alanhpereira/fluxdrive-g4/hardware/fluxdrive-g4.kicad_pcb

## KiCad design hardware/fluxdrive-g4.kicad_pcb (2026-10-22)

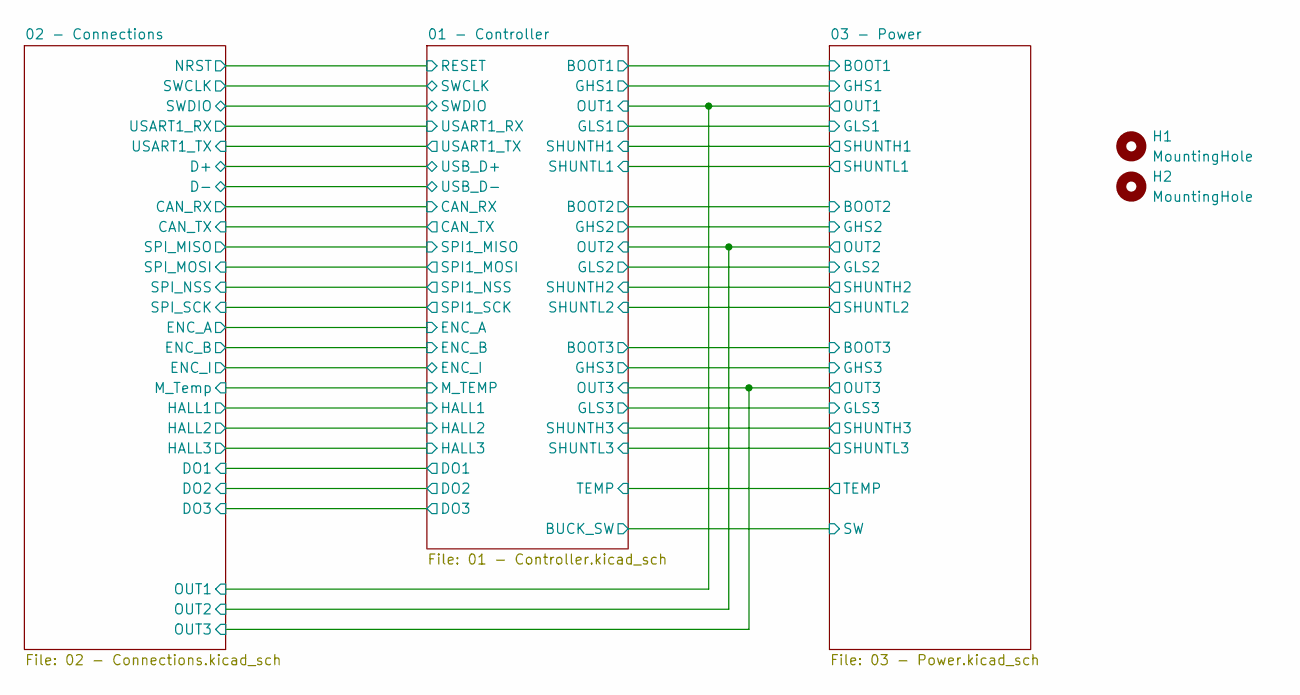
[picture p2: schematic fluxdrive-g4.kicad_sch]

Parts:
H1, H2: MountingHole; MountingHole_2.2mm_M2

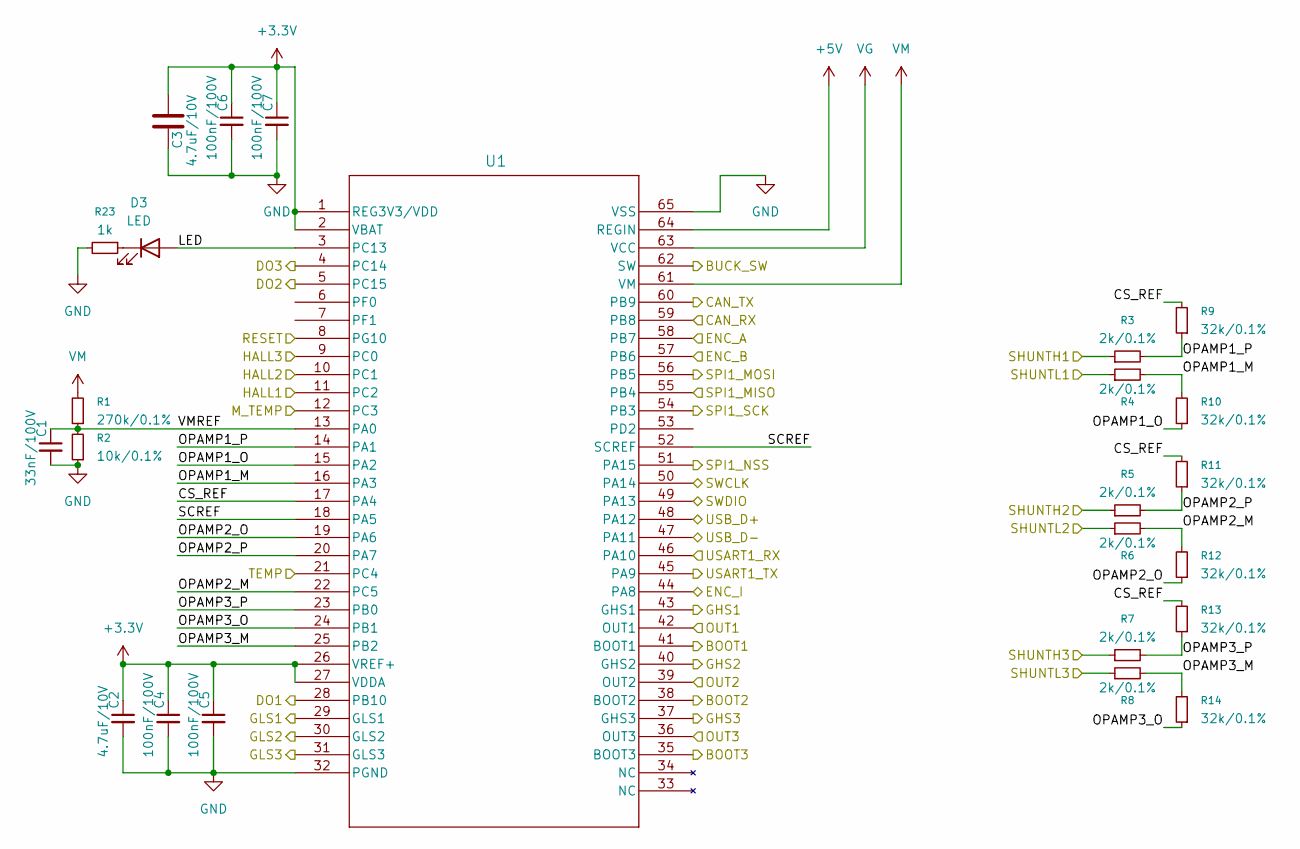
[picture p3: schematic 01 - Controller.kicad_sch]

Parts:
C1: 33nF/100V; C_0603_1608Metric
C2, C3: 4.7uF/10V; C_0603_1608Metric
C4, C5, C6, C7: 100nF/100V; C_0603_1608Metric
D3: LED; LED_0603_1608Metric
R1: 270k/0.1%; R_0603_1608Metric
R2: 10k/0.1%; R_0603_1608Metric
R3, R4, R5, R6, R7, R8: 2k/0.1%; R_0603_1608Metric
R9, R10, R11, R12, R13, R14: 32k/0.1%; R_0603_1608Metric
R23: 1k; R_0603_1608Metric
U1: STSPIN32G4TR; QFN_IN32G4_STM-L

Connections:
+3.3V: C2.1, C3.2, C4.1, C5.1, C6.1, C7.1, U1.1 (REG3V3/VDD), U1.2 (VBAT), U1.26 (VREF+), U1.27 (VDDA); also elsewhere on the board
+5V: U1.64 (REGIN); also elsewhere on the board
/01 - Controller/BOOT1: U1.41 (BOOT1); also elsewhere on the board
/01 - Controller/BOOT2: U1.38 (BOOT2); also elsewhere on the board
/01 - Controller/BOOT3: U1.35 (BOOT3); also elsewhere on the board
/01 - Controller/BUCK_SW: U1.62 (SW); also elsewhere on the board
/01 - Controller/CAN_RX: U1.59 (PB8); also elsewhere on the board
/01 - Controller/CAN_TX: U1.60 (PB9); also elsewhere on the board
/01 - Controller/CS_REF: R9.2, R11.2, R13.2, U1.17 (PA4)
/01 - Controller/DO1: U1.28 (PB10); also elsewhere on the board
/01 - Controller/DO2: U1.5 (PC15); also elsewhere on the board
/01 - Controller/DO3: U1.4 (PC14); also elsewhere on the board
/01 - Controller/ENC_A: U1.58 (PB7); also elsewhere on the board
/01 - Controller/ENC_B: U1.57 (PB6); also elsewhere on the board
/01 - Controller/ENC_I: U1.44 (PA8); also elsewhere on the board
/01 - Controller/GHS1: U1.43 (GHS1); also elsewhere on the board
/01 - Controller/GHS2: U1.40 (GHS2); also elsewhere on the board
/01 - Controller/GHS3: U1.37 (GHS3); also elsewhere on the board
/01 - Controller/GLS1: U1.29 (GLS1); also elsewhere on the board
/01 - Controller/GLS2: U1.30 (GLS2); also elsewhere on the board
/01 - Controller/GLS3: U1.31 (GLS3); also elsewhere on the board
/01 - Controller/HALL1: U1.11 (PC2); also elsewhere on the board
/01 - Controller/HALL2: U1.10 (PC1); also elsewhere on the board
/01 - Controller/HALL3: U1.9 (PC0); also elsewhere on the board
/01 - Controller/LED: D3.2 (A), U1.3 (PC13)
/01 - Controller/M_TEMP: U1.12 (PC3); also elsewhere on the board
/01 - Controller/OPAMP1_M: R4.2, R10.2, U1.16 (PA3)
/01 - Controller/OPAMP1_O: R10.1, U1.15 (PA2)
/01 - Controller/OPAMP1_P: R3.2, R9.1, U1.14 (PA1)
/01 - Controller/OPAMP2_M: R6.2, R12.2, U1.22 (PC5)
/01 - Controller/OPAMP2_O: R12.1, U1.19 (PA6)
/01 - Controller/OPAMP2_P: R5.2, R11.1, U1.20 (PA7)
/01 - Controller/OPAMP3_M: R8.2, R14.2, U1.25 (PB2)
/01 - Controller/OPAMP3_O: R14.1, U1.24 (PB1)
/01 - Controller/OPAMP3_P: R7.2, R13.1, U1.23 (PB0)
/01 - Controller/OUT1: U1.42 (OUT1); also elsewhere on the board
/01 - Controller/OUT2: U1.39 (OUT2); also elsewhere on the board
/01 - Controller/OUT3: U1.36 (OUT3); also elsewhere on the board
/01 - Controller/RESET: U1.8 (PG10); also elsewhere on the board
/01 - Controller/SCREF: U1.18 (PA5), U1.52 (SCREF)
/01 - Controller/SHUNTH1: R3.1; also elsewhere on the board
/01 - Controller/SHUNTH2: R5.1; also elsewhere on the board
/01 - Controller/SHUNTH3: R7.1; also elsewhere on the board
/01 - Controller/SHUNTL1: R4.1; also elsewhere on the board
/01 - Controller/SHUNTL2: R6.1; also elsewhere on the board
/01 - Controller/SHUNTL3: R8.1; also elsewhere on the board
/01 - Controller/SPI1_MISO: U1.55 (PB4); also elsewhere on the board
/01 - Controller/SPI1_MOSI: U1.56 (PB5); also elsewhere on the board
/01 - Controller/SPI1_NSS: U1.51 (PA15); also elsewhere on the board
/01 - Controller/SPI1_SCK: U1.54 (PB3); also elsewhere on the board
/01 - Controller/SWCLK: U1.50 (PA14); also elsewhere on the board
/01 - Controller/SWDIO: U1.49 (PA13); also elsewhere on the board
/01 - Controller/TEMP: U1.21 (PC4); also elsewhere on the board
/01 - Controller/USART1_RX: U1.46 (PA10); also elsewhere on the board
/01 - Controller/USART1_TX: U1.45 (PA9); also elsewhere on the board
/01 - Controller/USB_D+: U1.48 (PA12); also elsewhere on the board
/01 - Controller/USB_D-: U1.47 (PA11); also elsewhere on the board
/01 - Controller/VMREF: C1.1, R1.1, R2.2, U1.13 (PA0)
GND: C1.2, C2.2, C3.1, C4.2, C5.2, C6.2, C7.2, R2.1, R23.2, U1.32 (PGND), U1.65 (VSS); also elsewhere on the board
unnamed: D3.1 (K), R23.1
VG: U1.63 (VCC); also elsewhere on the board
VM: R1.2, U1.61 (VM); also elsewhere on the board

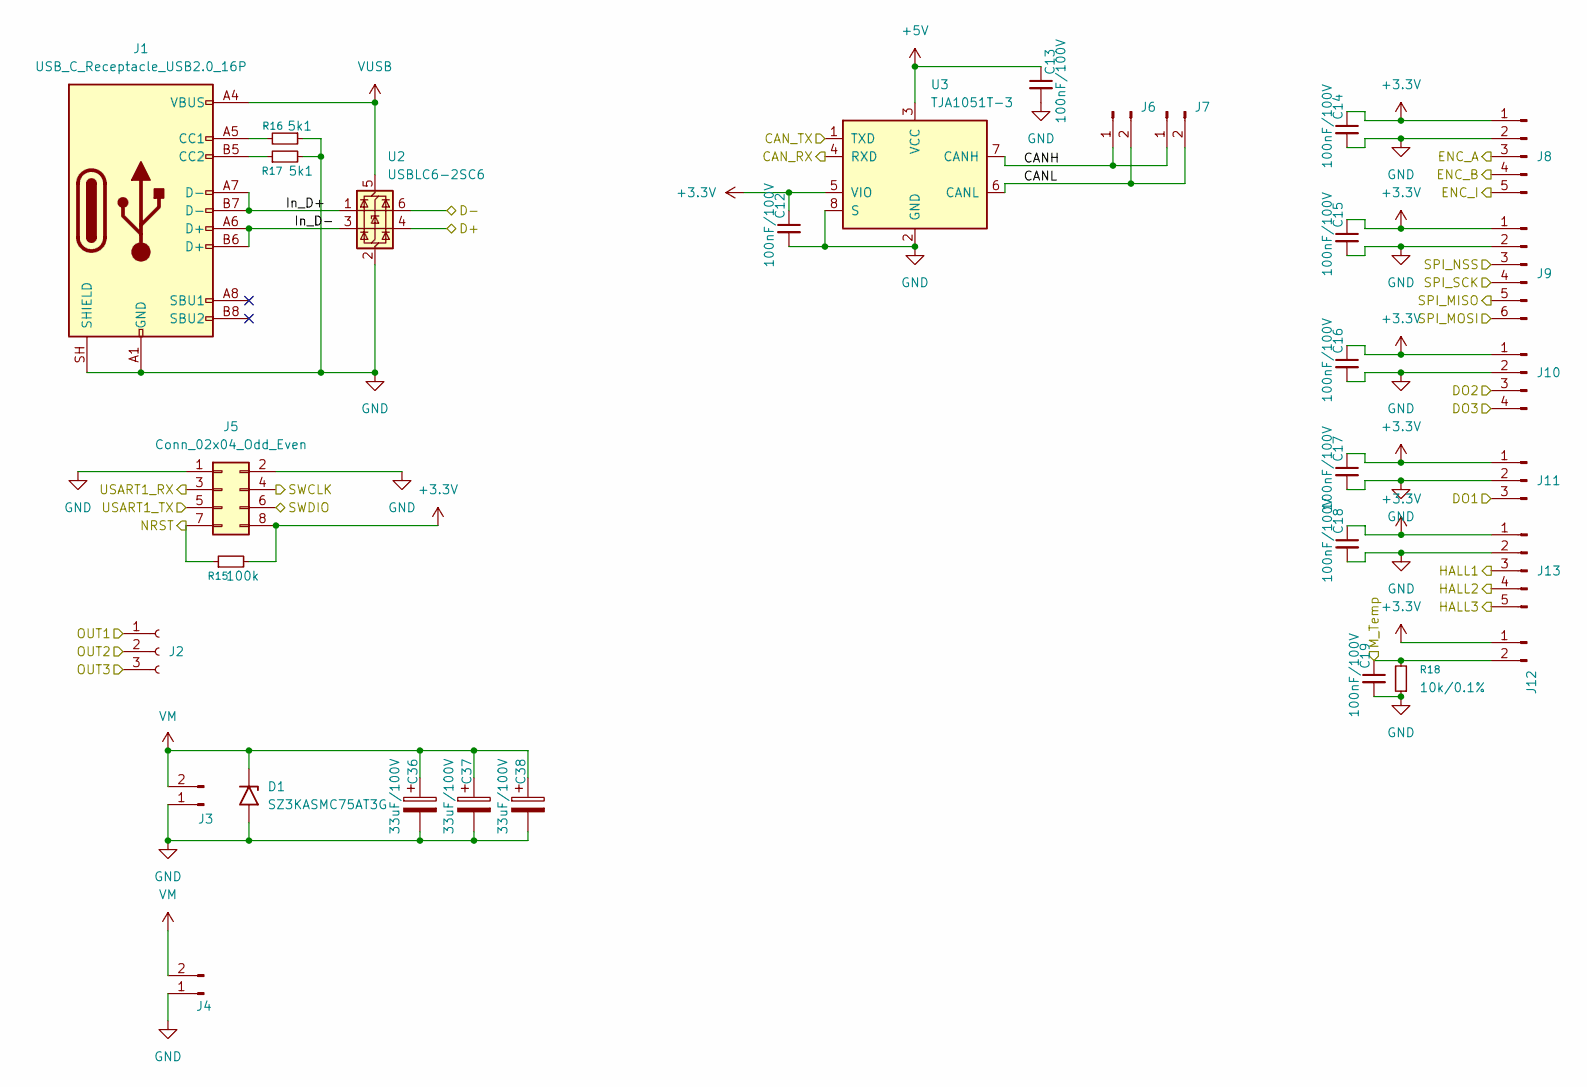
[picture p4: schematic 02 - Connections.kicad_sch]

Parts:
C12, C13, C14, C15, C16, C17, C18, C19: 100nF/100V; C_0603_1608Metric
C36, C37, C38: 33uF/100V; CP_Radial_D8.0mm_P3.50mm
D1: SZ3KASMC75AT3G; D_SMC
J1: USB_C_Receptacle_USB2.0_16P; USB_C_Receptacle_HRO_TYPE-C-31-M-12; LCSC Part C165948
J2: Conn_01x03_Socket; CONN-TH_3P-P3.50_MR30PB-F30.G.Y
J3, J4: Conn_01x02_Pin; AMASS_XT30UPB-M
J5: Conn_02x04_Odd_Even; PinHeader_2x04_P2.54mm_Vertical
J6, J7, J12: Conn_01x02_Pin; JST_PH_B2B-PH-K_1x02_P2.00mm_Vertical
J8, J13: Conn_01x05_Pin; JST_PH_B5B-PH-K_1x05_P2.00mm_Vertical
J9: Conn_01x06_Pin; JST_PH_B6B-PH-K_1x06_P2.00mm_Vertical
J10: Conn_01x04_Pin; JST_PH_B4B-PH-K_1x04_P2.00mm_Vertical
J11: Conn_01x03_Pin; JST_PH_B3B-PH-K_1x03_P2.00mm_Vertical
R15: 100k; R_0603_1608Metric
R16, R17: 5k1; R_0603_1608Metric
R18: 10k/0.1%; R_0603_1608Metric
U2: USBLC6-2SC6; SOT-23-6; LCSC Part C2827654
U3: TJA1051T-3; SOIC-8_3.9x4.9mm_P1.27mm

Connections:
+3.3V: C12.1, C14.1, C15.1, C16.1, C17.1, C18.1, J5.8, J8.1, J9.1, J10.1, J11.1, J12.1, J13.1, R15.2, U3.5 (VIO); also elsewhere on the board
+5V: C13.1, U3.3 (VCC); also elsewhere on the board
/01 - Controller/CAN_RX: U3.4 (RXD); also elsewhere on the board
/01 - Controller/CAN_TX: U3.1 (TXD); also elsewhere on the board
/01 - Controller/DO1: J11.3; also elsewhere on the board
/01 - Controller/DO2: J10.3; also elsewhere on the board
/01 - Controller/DO3: J10.4; also elsewhere on the board
/01 - Controller/ENC_A: J8.3; also elsewhere on the board
/01 - Controller/ENC_B: J8.4; also elsewhere on the board
/01 - Controller/ENC_I: J8.5; also elsewhere on the board
/01 - Controller/HALL1: J13.3; also elsewhere on the board
/01 - Controller/HALL2: J13.4; also elsewhere on the board
/01 - Controller/HALL3: J13.5; also elsewhere on the board
/01 - Controller/M_TEMP: C19.1, J12.2, R18.2; also elsewhere on the board
/01 - Controller/OUT1: J2.1; also elsewhere on the board
/01 - Controller/OUT2: J2.2; also elsewhere on the board
/01 - Controller/OUT3: J2.3; also elsewhere on the board
/01 - Controller/RESET: J5.7, R15.1; also elsewhere on the board
/01 - Controller/SPI1_MISO: J9.5; also elsewhere on the board
/01 - Controller/SPI1_MOSI: J9.6; also elsewhere on the board
/01 - Controller/SPI1_NSS: J9.3; also elsewhere on the board
/01 - Controller/SPI1_SCK: J9.4; also elsewhere on the board
/01 - Controller/SWCLK: J5.4; also elsewhere on the board
/01 - Controller/SWDIO: J5.6; also elsewhere on the board
/01 - Controller/USART1_RX: J5.3; also elsewhere on the board
/01 - Controller/USART1_TX: J5.5; also elsewhere on the board
/01 - Controller/USB_D+: U2.4 (I/O2); also elsewhere on the board
/01 - Controller/USB_D-: U2.6 (I/O1); also elsewhere on the board
/02 - Connections/CANH: J6.1, J7.1, U3.7 (CANH)
/02 - Connections/CANL: J6.2, J7.2, U3.6 (CANL)
/02 - Connections/In_D+: J1.A7 (D-), J1.B7 (D-), U2.1 (I/O1)
/02 - Connections/In_D-: J1.A6 (D+), J1.B6 (D+), U2.3 (I/O2)
GND: C12.2, C13.2, C14.2, C15.2, C16.2, C17.2, C18.2, C19.2, C36.2, C37.2, C38.2, D1.2 (A2), J1.A1 (GND), J1.A12 (GND), J1.B1 (GND), J1.B12 (GND), J1.SH (SHIELD), J3.1, J4.1, J5.1, J5.2, J8.2, J9.2, J10.2, J11.2, J13.2, R16.1, R17.2, R18.1, U2.2 (GND), U3.2 (GND), U3.8 (S); also elsewhere on the board
unnamed: J1.A5 (CC1), R16.2
unnamed: J1.B5 (CC2), R17.1
VM: C36.1, C37.1, C38.1, D1.1 (A1), J3.2, J4.2; also elsewhere on the board
VUSB: J1.A4 (VBUS), J1.A9 (VBUS), J1.B4 (VBUS), J1.B9 (VBUS), U2.5 (VBUS); also elsewhere on the board

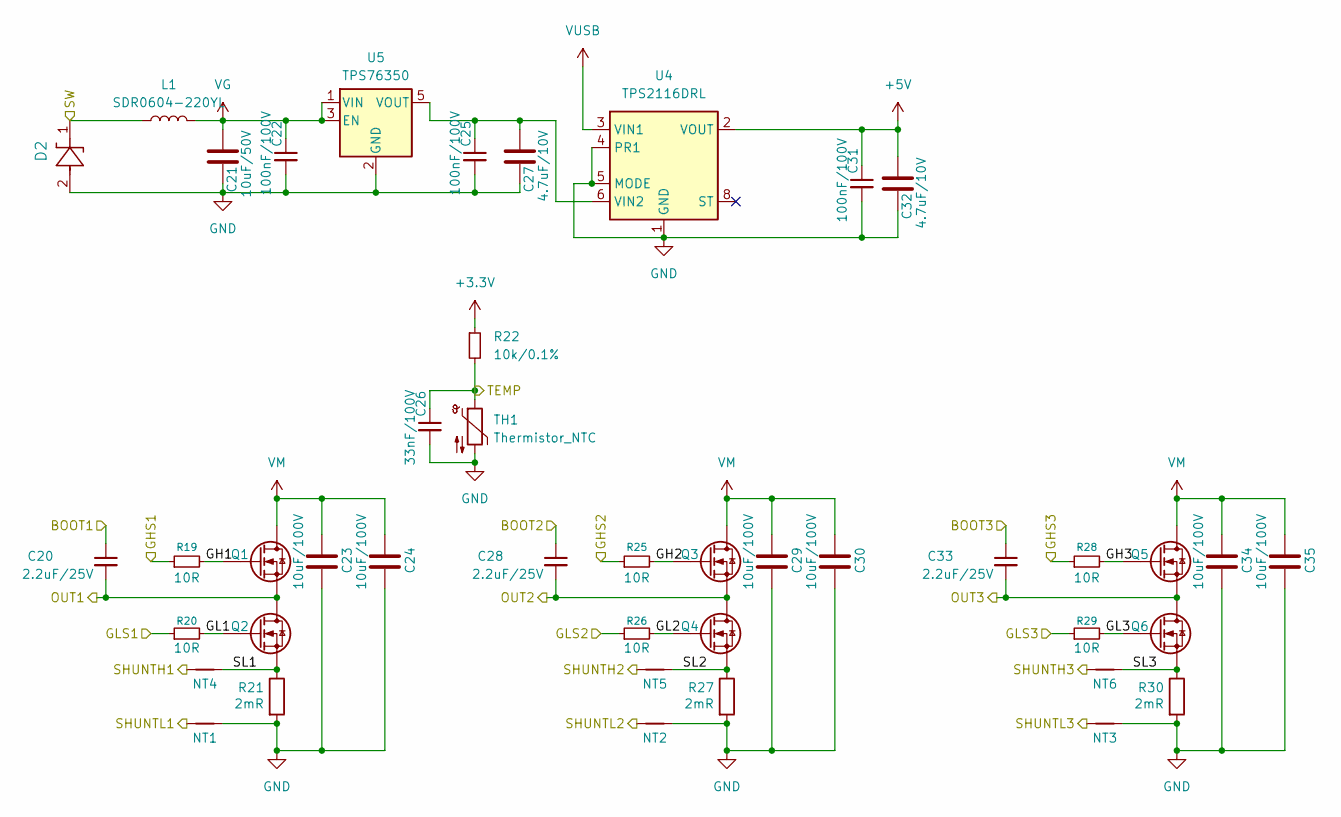
[picture p5: schematic 03 - Power.kicad_sch]

Parts:
C20, C28, C33: 2.2uF/25V; C_0603_1608Metric
C21: 10uF/50V; C_1206_3216Metric
C22, C25, C31: 100nF/100V; C_0603_1608Metric
C23, C24, C29, C30, C34, C35: 10uF/100V; C_1210_3225Metric
C26: 33nF/100V; C_0603_1608Metric
C27, C32: 4.7uF/10V; C_0603_1608Metric
D2: STPS1H100A; SMA_STM-L
L1: SDR0604-220YL; L_Bourns_SDR0604
NT1, NT2, NT3, NT4, NT5, NT6: NetTie_2; NetTie-2_SMD_Pad0.1mm
Q1, Q2, Q3, Q4, Q5, Q6: DI100N10PQ; P260_QFN5x6_TDSON-8
R19, R20, R25, R26, R28, R29: 10R; R_0603_1608Metric
R21, R27, R30: 2mR; R_0612_1632Metric
R22: 10k/0.1%; R_0603_1608Metric
TH1: Thermistor_NTC; R_0603_1608Metric
U4: TPS2116DRL; SOT-583-8
U5: TPS76350; SOT-23-5

Connections:
+3.3V: R22.1; also elsewhere on the board
+5V: C31.1, C32.2, U4.2 (VOUT), U4.7 (VOUT); also elsewhere on the board
/01 - Controller/BOOT1: C20.1; also elsewhere on the board
/01 - Controller/BOOT2: C28.1; also elsewhere on the board
/01 - Controller/BOOT3: C33.1; also elsewhere on the board
/01 - Controller/BUCK_SW: D2.1, L1.1; also elsewhere on the board
/01 - Controller/GHS1: R19.1; also elsewhere on the board
/01 - Controller/GHS2: R25.1; also elsewhere on the board
/01 - Controller/GHS3: R28.1; also elsewhere on the board
/01 - Controller/GLS1: R20.1; also elsewhere on the board
/01 - Controller/GLS2: R26.1; also elsewhere on the board
/01 - Controller/GLS3: R29.1; also elsewhere on the board
/01 - Controller/OUT1: C20.2, Q1.S, Q2.D; also elsewhere on the board
/01 - Controller/OUT2: C28.2, Q3.S, Q4.D; also elsewhere on the board
/01 - Controller/OUT3: C33.2, Q5.S, Q6.D; also elsewhere on the board
/01 - Controller/SHUNTH1: NT4.1; also elsewhere on the board
/01 - Controller/SHUNTH2: NT5.1; also elsewhere on the board
/01 - Controller/SHUNTH3: NT6.1; also elsewhere on the board
/01 - Controller/SHUNTL1: NT1.1; also elsewhere on the board
/01 - Controller/SHUNTL2: NT2.1; also elsewhere on the board
/01 - Controller/SHUNTL3: NT3.1; also elsewhere on the board
/01 - Controller/TEMP: C26.1, R22.2, TH1.1; also elsewhere on the board
/03 - Power/GH1: Q1.G, R19.2
/03 - Power/GH2: Q3.G, R25.2
/03 - Power/GH3: Q5.G, R28.2
/03 - Power/GL1: Q2.G, R20.2
/03 - Power/GL2: Q4.G, R26.2
/03 - Power/GL3: Q6.G, R29.2
/03 - Power/SL1: NT4.2, Q2.S, R21.1
/03 - Power/SL2: NT5.2, Q4.S, R27.1
/03 - Power/SL3: NT6.2, Q6.S, R30.1
GND: C21.1, C22.2, C23.2, C24.2, C25.2, C26.2, C27.1, C29.2, C30.2, C31.2, C32.1, C34.2, C35.2, D2.2, NT1.2, NT2.2, NT3.2, R21.2, R27.2, R30.2, TH1.2, U4.1 (GND), U4.4 (PR1), U4.5 (MODE), U5.2 (GND); also elsewhere on the board
unnamed: C25.1, C27.2, U4.6 (VIN2), U5.5 (VOUT)
VG: C21.2, C22.1, L1.2, U5.1 (VIN), U5.3 (EN); also elsewhere on the board
VM: C23.1, C24.1, C29.1, C30.1, C34.1, C35.1, Q1.D, Q3.D, Q5.D; also elsewhere on the board
VUSB: U4.3 (VIN1); also elsewhere on the board

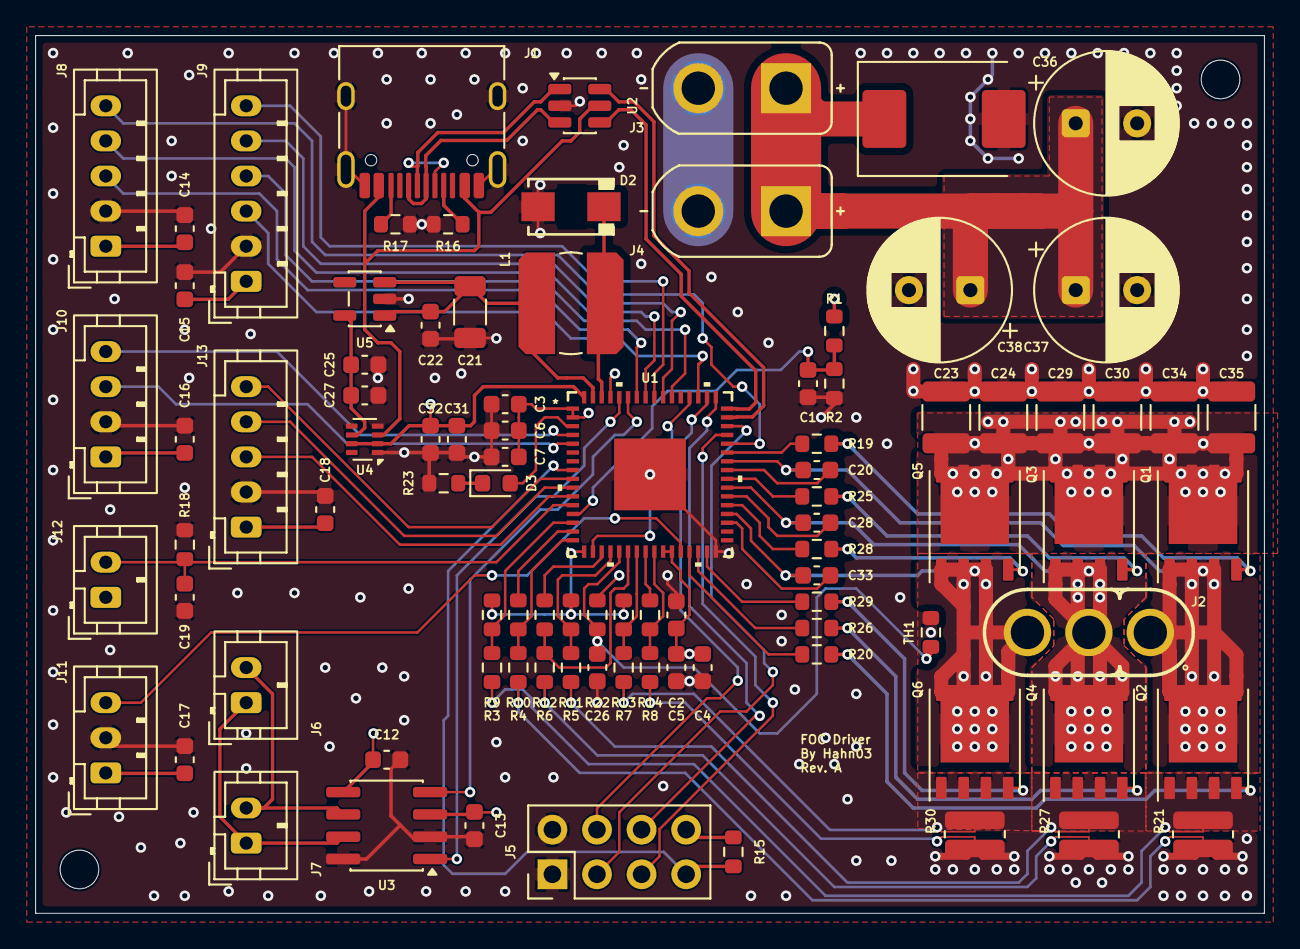
[picture p6: board fluxdrive-g4.kicad_pcb from above]

Board: 4 copper layers, 70.0 x 50.0 mm, 100 parts (0 on the bottom side), 79 nets.
