alanhpereira/fluxdrive-g4/Core/Src/main.c

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
/* Includes ------------------------------------------------------------------*/
#include "main.h"
#include "adc.h"
#include "cordic.h"
#include "dac.h"
#include "dma.h"
#include "fdcan.h"
#include "i2c.h"
#include "opamp.h"
#include "spi.h"
#include "tim.h"
#include "usart.h"
#include "usb_device.h"
#include "gpio.h"

/* USER CODE BEGIN Includes */
#include "boot.h"
#include "mt6835.h"
#include "motorCtrl.h"
#include "calib.h"
#include "params.h"
/* USER CODE END Includes */


/* USER CODE BEGIN PV */

static uint8_t ready = 0;
static uint8_t nFaultDig = 0;
/* USER CODE END PV */

void SystemClock_Config(void);
/**
 * @brief  The application entry point.
 * @retval int
 */
int main(void) {
	/* USER CODE BEGIN 1 */
	boot_check(); /* MSG_REBOOT to DFU: jump to the ST bootloader before anything is set up */
	/* ISR path into CCM SRAM (.ccmram in the linker script), before anything can call into it */
	{
		extern uint32_t _sccmram, _eccmram, _siccmram;
		const uint32_t* src = &_siccmram;
		for (uint32_t* dst = &_sccmram; dst < &_eccmram;) *dst++ = *src++;
		__DSB();
		__ISB();
	}
	/* USER CODE END 1 */

	/* MCU Configuration--------------------------------------------------------*/

	/* Reset of all peripherals, Initializes the Flash interface and the Systick. */
	HAL_Init();

	/* Configure the system clock */
	SystemClock_Config();

	/* USER CODE BEGIN SysInit */
	/* flash runs at 4 wait states and the ISR path (~6 KB) does not fit the 1 KB instruction cache: without
	 * prefetch every miss stalls. PREFETCH_ENABLE is 0 in the generated hal_conf, so it is switched on here */
	__HAL_FLASH_PREFETCH_BUFFER_ENABLE();
	/* USER CODE END SysInit */

	/* Initialize all configured peripherals */
	MX_GPIO_Init();
	MX_DMA_Init();
	MX_ADC1_Init();
	MX_FDCAN1_Init();
	MX_I2C3_Init();
	MX_OPAMP1_Init();
	MX_OPAMP2_Init();
	MX_OPAMP3_Init();
	MX_TIM1_Init();
	MX_ADC2_Init();
	MX_DAC1_Init();
	MX_SPI1_Init();
	MX_TIM4_Init();
	MX_USART1_UART_Init();
	MX_CORDIC_Init();
	MX_TIM2_Init();
	MX_USB_Device_Init();
	/* USER CODE BEGIN 2 */
	HAL_TIM_Base_Start(&htim2);
	// set cs mid reference to vcc/2
	HAL_Delay(5);
	cmd_init();
	if (params_load()) { /* defaults: not calibrated yet */
	}
	pi_apply();
	initMotor();
	/* USER CODE END 2 */

	/* Infinite loop */
	/* USER CODE BEGIN WHILE */
	while (1) {
		cmd_poll();
		checkAndClearBridgeFault();
		ready = HAL_GPIO_ReadPin(DRV_RDY_GPIO_Port, DRV_RDY_Pin);
		nFaultDig = HAL_GPIO_ReadPin(GPIOE, GPIO_PIN_15);
		/* USER CODE END WHILE */

		/* USER CODE BEGIN 3 */
	}
	/* USER CODE END 3 */
}

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
/* USER CODE BEGIN 4 */
/* MT6835 reads are triggered by TIM1 and collected in currentLoop() (see mt6835.c), no SPI callbacks */
/* USER CODE END 4 */
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
