alanhpereira/fluxdrive-g4/fluxdrive-g4.ioc

Mcu.UserName=STM32G431VBTx
PA0.GPIO_Label=VIN_REF
PA0.Signal=ADC2_IN1
PA1.Signal=OPAMP1_VINP
PA10.Signal=USART1_RX
PA11.Signal=USB_DM
PA12.Signal=USB_DP
PA13.Signal=SYS_JTMS-SWDIO
PA14.Signal=SYS_JTCK-SWCLK
PA15.GPIO_Label=SPI_NCS
PA15.Signal=GPIO_Output
PA2.GPIO_Label=CS1
PA2.Signal=SharedAnalog_PA2
PA3.Signal=OPAMP1_VINM
PA4.GPIO_Label=CS_REF
PA4.Signal=COMP_DAC11_group
PA5.GPIO_Label=SCREF
PA5.Signal=COMP_DAC12_group
PA6.GPIO_Label=CS2
PA6.Signal=SharedAnalog_PA6
PA7.Signal=OPAMP2_VINP
PA8.GPIO_Label=ENC_I
PA8.Signal=S_TIM4_ETR
PA9.Signal=USART1_TX
PB0.Signal=OPAMP3_VINP
PB1.GPIO_Label=CS3
PB1.Signal=SharedAnalog_PB1
PB10.Signal=GPIO_Output
PB2.Signal=OPAMP3_VINM
PB3.Signal=SPI1_SCK
PB4.Signal=SPI1_MISO
PB5.Signal=SPI1_MOSI
PB6.Signal=S_TIM4_CH1
PB7.Signal=S_TIM4_CH2
PB8-BOOT0.Signal=FDCAN1_RX
PB9.Signal=FDCAN1_TX
PC0.GPIO_Label=HALL3
PC0.Signal=GPXTI0
PC1.GPIO_Label=HALL2
PC1.Signal=GPXTI1
PC13.Signal=GPIO_Output
PC14-OSC32_IN.Signal=GPIO_Input
PC15-OSC32_OUT.Signal=GPIO_Output
PC2.GPIO_Label=HALL1
PC2.Signal=GPXTI2
PC3.GPIO_Label=MOT_TEMP
PC3.Signal=ADC1_IN9
PC4.GPIO_Label=DRV_TEMP
PC4.Signal=ADC2_IN5
PC5.Signal=OPAMP2_VINM
PC8.Signal=I2C3_SCL
PC9.Signal=I2C3_SDA
PE10.GPIO_Label=GLS2
PE10.Signal=TIM1_CH2N
PE11.GPIO_Label=GHS2
PE11.Signal=S_TIM1_CH2
PE12.GPIO_Label=GLS3
PE12.Signal=TIM1_CH3N
PE13.GPIO_Label=GHS3
PE13.Signal=S_TIM1_CH3
PE14.GPIO_Label=DRV_RDY
PE14.Signal=GPIO_Input
PE15.Signal=TIM1_BKIN
PE7.GPIO_Label=Wake
PE7.Signal=GPIO_Output
PE8.GPIO_Label=GLS1
PE8.Signal=TIM1_CH1N
PE9.GPIO_Label=GHS1
PE9.Signal=S_TIM1_CH1
