alanhpereira/fluxdrive-g4/Core/Src/motorCtrl.c

/* the 25 kHz ISR body: -O2 even in a size-optimized (-Os) build, the loop must end ~19 us after the ADC.
 * Before the includes, so the inline helpers (pi_ctrl.h, cordicMgr.h) are compiled the same way */
#pragma GCC optimize("O2")

#include "motorCtrl.h"

#include <math.h>
#include <string.h>

#include "i2c.h"
#include "link.h"
#include "cordicMgr.h"
#include "hall.h"
#include "hfi.h"
#include "mt6835.h"
#include "params.h"
#include "calib.h"
#include "pi_ctrl.h"
#include "temp.h" /* g_i_vel */

#define SQRT3_2 0.8660254f
#define INV_SQRT3 0.57735027f
#define POLE_PAIRS 7
#define ELEC_OFFSET 0

static uint16_t seq;
typedef struct {
	uint8_t sync[2];  // 0xA5, 0x5A
	uint16_t seq;
	float v[16];
	uint32_t sum;  // frame_sum() of the 17 words before it: lets the receiver confirm a frame by itself
} Frame;		   // offsets: seq at 2, v at 4, sum at 68, so natural alignment, no padding
_Static_assert(sizeof(Frame) == 72, "frame size");

/* rotate-and-add over the first 17 little-endian words; must match software/fluxstudio.py */
static uint32_t frame_sum(const Frame* f) {
	uint32_t s = 0x5A5AA5A5u;
	for (int i = 0; i < 17; i++) {
		uint32_t w;
		memcpy(&w, (const uint8_t*)f + 4 * i, 4);
		s = ((s << 1) | (s >> 31)) + w;
	}
	return s;
}

Frame telemetry;

static float dc_float;
static float center_f;
static float duty_k; /* g_max_duty_cycle / g_pwm_res: the share of the bus the duty window spans */

volatile float g_iq, g_id;
volatile float g_vd_f, g_vq_f, g_iq_f;
volatile float g_vel, g_pos, g_rpm;
volatile uint8_t g_home_req;
volatile int32_t g_home_pos;
volatile int32_t g_pos_cnt;
volatile int32_t g_pos_ref_cnt;
volatile uint8_t g_ramp_bypass;
volatile uint32_t g_loop_cyc, g_loop_cyc_max; /* currentLoop() run time, CPU cycles */
volatile uint32_t g_tlm_drop;				   /* telemetry frames that found the link queue full */
volatile uint16_t g_sl_lost_n;				  /* sensorless: consecutive cycles HFI was not tracking, see SL_LOST_N */
volatile uint16_t g_enc_lost_n;				  /* consecutive cycles without a fresh encoder angle, see ENC_LOST_N */

volatile uint8_t control_enabled = 0;

static int16_t cycles_since_last_frame = 0;

void disableMotor() {
	disableCS();
	disableBridge();
}

HAL_StatusTypeDef initMotor() {
	HAL_StatusTypeDef status;
	cordic_init();
	CoreDebug->DEMCR |= CoreDebug_DEMCR_TRCENA_Msk; /* DWT cycle counter, for the loop timing */
	DWT->CYCCNT = 0;
	DWT->CTRL |= DWT_CTRL_CYCCNTENA_Msk;
	status = initCS();
	if (status != HAL_OK) {
		disableMotor();
		return status;
	}
	status = initBridge();
	if (status != HAL_OK) {
		disableMotor();
		return status;
	}
	dc_float = g_max_duty_cycle * INV_SQRT3;
	center_f = (float)g_half_duty_cycle + 0.5f;
	duty_k = (float)g_max_duty_cycle / (float)g_pwm_res;
	MT6835_StartBurst(&hMT6835);
	hall_init();
	telemetry.sync[0] = 0xA5;
	telemetry.sync[1] = 0x5A;
	control_enabled = 1;
	cs_boot_offsets(); /* CTRL_OFF: zero volts (or the bridge still off), no current on a still rotor */

	return HAL_OK;
}
static inline void clarke(float ia, float ib, float ic, float* al, float* be) {
	*al = (2.0f * ia - ib - ic) * (1.0f / 3.0f);
	*be = (ib - ic) * INV_SQRT3;
}

static inline void park(float al, float be, float s, float c, float* d, float* q) {
	*d = al * c + be * s;
	*q = -al * s + be * c;
}

static inline void ipark(float d, float q, float s, float c, float* al, float* be) {
	*al = d * c - q * s;
	*be = d * s + q * c;
}
/* returns 0 when nothing was written (the previous duties stay on) */
int SVPWM(float alpha, float beta) {
	if (HAL_GetTick() < g_lastFaultCleared + FAULT_CLEAR_MIN_TIME) return 0;
	float base = -0.5f * alpha;
	float height = SQRT3_2 * beta;
	// calculate raw voltages
	float va = alpha;
	float vb = base + height;
	float vc = base - height;
	float min_v = va > vb ? (vb > vc ? vc : vb) : (va > vc ? vc : va);
	float max_v = va < vb ? (vb < vc ? vc : vb) : (va < vc ? vc : va);
	float off = (min_v + max_v) * -0.5f;
	int32_t out_a = (int32_t)((va + off) * dc_float + center_f);
	int32_t out_b = (int32_t)((vb + off) * dc_float + center_f);
	int32_t out_c = (int32_t)((vc + off) * dc_float + center_f);
	out_a = out_a < 0 ? 0 : out_a > g_max_duty_cycle ? g_max_duty_cycle
													 : out_a;
	out_b = out_b < 0 ? 0 : out_b > g_max_duty_cycle ? g_max_duty_cycle
													 : out_b;
	out_c = out_c < 0 ? 0 : out_c > g_max_duty_cycle ? g_max_duty_cycle
													 : out_c;
	setDuty(out_a, out_b, out_c);
	return 1;
}

/* ------------------------------------------------------------------ position / speed estimate */
/* PLL: critically damped, kp = 2*wb, ki = wb^2. 2000 rad/s (~320 Hz) leaves room for a speed loop of ~100 Hz */
#define PLL_BW 2000.0f
#define PLL_KP (2.0f * PLL_BW)
#define PLL_KI_TS (PLL_BW * PLL_BW / CTRL_FS_HZ)

static pos_q32_t s_home;	/* raw position at home, motor direction */
static pos_q32_t s_pos;		/* from home, motor direction */
static pos_q32_t s_pos_ref; /* latched from g_pos_ref_new */
static int64_t s_pos_ff_q;	/* CSP interpolation: added to s_pos_ref every cycle (Q32.32 turns per cycle) */
static uint16_t s_pos_ff_n; /* ...for this many more cycles */
static float s_pos_ff;		/* turn/s, the matching speed feed-forward while it lasts */
static pos_q32_t s_pos_tgt; /* where the segment in progress ends */
static uint16_t s_pos_ff_hold; /* after a segment: cycles left to carry on at its rate, waiting for the next one */
static uint8_t s_pos_snap;	   /* the segment ends exactly on s_pos_tgt (a hold) */
/* Q32.32 -> float inline: a plain (float) of an int64 is a library call (__aeabi_l2f, in flash) */
static inline float q32_to_f(int64_t x) {
	return (float)(int32_t)(x >> 32) + (float)(uint32_t)x * (float)(1.0 / POS_Q32_ONE);
}
static uint32_t s_pll_ph;	/* Q32 = one turn, motor direction */
static float s_pll_vel;		/* turn/s */
static uint8_t s_pll_init;
static float s_vel;				  /* turn/s, encoder PLL blended with the observer PLL: what the loops use */
static float s_vel_ref_eff = NAN; /* speed reference actually fed to the speed PI, for telemetry */

/* the main/tick -> ISR requests (home, position reference / CSP segment, position here), from motion_update()
 * on the cycles that carry one. In flash to leave CCM room: at most one cycle per CSP frame */
static __attribute__((noinline)) void motion_latch(pos_q32_t p) {
	if (g_home_req) {
		s_home = p - ((pos_q32_t)g_home_pos << 16); /* g_home_pos: Q16.16 turns */
		g_home_req = 0;
	}
	if (g_pos_ref_req) {
		s_pos_ff_n = g_pos_ff_n_new;
		if (s_pos_ff_n == 0) { /* a fixed reference (USB RUN_POS) */
			s_pos_ref = g_pos_ref_new;
			s_pos_ff = 0.0f;
			s_pos_ff_hold = 0;
		}
		else {
			/* CSP / PP segment ending at g_pos_ref_new. The reference moves at the master's rate (its step / period),
			   whenever the frame arrived, plus half of its offset from the master's path per period. Reaching each
			   target in exactly one period instead turned the arrival jitter (PC timing, the 1 ms tick) into speed
			   steps: a 6.5 ms gap then a 3.5 ms one gave 60 % then 125 % of the speed, measured. A hold (step 0)
			   goes exactly onto the target */
			s_pos_tgt = g_pos_ref_new;
			const int32_t n = s_pos_ff_n;
			const int64_t qb = g_pos_ff_q_new;					/* the master's rate, Q32.32 turns per cycle */
			const int64_t e = s_pos_ref - (s_pos_tgt - qb * n); /* the reference's offset from the master's path */
			if (e > -INT32_MAX && e < INT32_MAX && qb > -INT32_MAX && qb < INT32_MAX) { /* 32-bit maths, no library calls */
				const int32_t q = (int32_t)qb - (qb ? (int32_t)e / (2 * n) : (int32_t)e / n);
				s_pos_ff_q = q;
				s_pos_ff = (float)q * ((float)CTRL_FS_HZ / 4294967296.0f); /* the rate it really moves at */
				s_pos_snap = (qb == 0);
			}
			else { /* half a turn or more off: start on the master's path */
				s_pos_ref = s_pos_tgt - qb * n;
				s_pos_ff_q = qb;
				s_pos_ff = g_pos_ff_new;
				s_pos_snap = 1;
			}
			s_pos_ff_hold = n;
		}
		g_pos_ref_req = 0;
	}
	if (g_pos_here_req) { /* after the two above: it wins over a reference latched in the same cycle */
		s_pos_ref = p - s_home;
		s_pos_ff_n = 0;
		s_pos_ff_hold = 0;
		s_pos_ff = 0.0f;
		g_pos_here_req = 0;
	}
}

/* p: raw position from the angle source, motor direction: the encoder, or the accumulated Hall / Hall + HFI
 * angle (hall_pos()). ph: encoder phase (Q32 = one turn, motor direction) for the encoder PLL. age_s: how long
 * ago the sensor sampled it. fresh = 0 when there was no new sample (stream stalled, CRC): the PLL then only
 * predicts */
static void motion_update(pos_q32_t p, uint32_t ph, int fresh, float age_s) {
	if (g_home_req | g_pos_ref_req | g_pos_here_req) motion_latch(p);
	if (s_pos_ff_n) {
		if (--s_pos_ff_n || !s_pos_snap)
			s_pos_ref += s_pos_ff_q;
		else
			s_pos_ref = s_pos_tgt; /* a hold ends exactly on the target */
	}
	else if (s_pos_ff_hold) {
		/* the next segment is late (a CSP frame arriving after the period, or on the far side of the 1 ms tick):
		   carry on at the same rate with the feed-forward for up to one more period, then hold. Stopping here
		   and dropping the feed-forward was measured as ~1 ms speed-reference dips of the full speed: clicks */
		s_pos_ref += s_pos_ff_q;
		if (--s_pos_ff_hold == 0) s_pos_ff = 0.0f;
	}
	s_pos = p - s_home;
	g_pos_cnt = (int32_t)(s_pos >> 16); /* Q16.16 turns, CANopen 0x6064: wraps at +-32768 turns */
	g_pos_ref_cnt = (int32_t)(s_pos_ref >> 16); /* CANopen 0x6062 / following error: the interpolated reference */
	g_pos = q32_to_f(s_pos);

	if (!s_pll_init) {
		if (!fresh) return; /* no encoder frame yet: nothing to lock onto */
		s_pll_ph = ph;
		s_pll_vel = 0.0f;
		s_pll_init = 1;
	}
	/* compare with where the PLL says the rotor was when the sensor sampled, not where it is now */
	uint32_t pred = s_pll_ph - (uint32_t)(int32_t)(s_pll_vel * age_s * 4294967296.0f);
	float err = fresh ? (float)(int32_t)(ph - pred) * (1.0f / 4294967296.0f) : 0.0f; /* turns, wraps correctly */
	s_pll_vel += PLL_KI_TS * err;
	s_pll_ph += (uint32_t)(int32_t)((s_pll_vel + PLL_KP * err) * (4294967296.0f / CTRL_FS_HZ));
}

/* ------------------------------------------------------------------ speed / position loops */
/* The speed reference is slewed at g_params.acc_lim (rpm/s, 0 = off). Measured: ~22000 rpm/s per amp, so
 * 60000 rpm/s is ~3 A plus friction. That keeps the observer's load-dependent flux error small (it drops
 * to ~0.8 of lambda at 8 A) and stays clear of the ~8 A where the encoder mount slips */

/* regen clamp (calib.h): share of the braking current the bus can take now, 1 = all of it. From currentLoop() */
static float s_regen_k = 1.0f;

/* in CTRL_RUN with g_loop != LOOP_CURRENT: writes g_iq_ref at OUTER_FS_HZ. Returns 1 on the cycles it ran */
static __attribute__((noinline)) int outer_loops(ctrl_mode_t mode) {
	static loop_t prev = LOOP_CURRENT;
	static int div;
	static float vramp; /* slewed speed reference, turn/s */
	int ran = 0;
	loop_t lp = (mode == CTRL_RUN) ? g_loop : LOOP_CURRENT;

	if (lp == LOOP_CURRENT) {
		pi_reset(&g_pi_vel);
		s_vel_ref_eff = NAN;
		div = OUTER_DIV; /* run on the first cycle after switching in */
	}
	else {
		if (prev == LOOP_CURRENT) {
			g_pi_vel.integ = g_iq_ref; /* bumpless: carry on from the present current */
			vramp = s_vel;			   /* and ramp from the present speed */
		}
		if (++div >= OUTER_DIV) {
			div = 0;
			ran = 1;
			float lim = g_params.vel_lim;
			float vref = g_vel_ref;
			if (lp == LOOP_POS) {
				/* exact integer difference; only the (small) error becomes a float */
				float err = q32_to_f(s_pos_ref - s_pos);
				vref = s_pos_ff + g_params.pos_kp * err;
			}
			if (vref > lim)
				vref = lim;
			else if (vref < -lim)
				vref = -lim;
			const float dv = g_params.acc_lim * ((float)OUTER_DIV / (60.0f * CTRL_FS_HZ)); /* rpm/s -> turn/s per step */
			if (s_regen_k < 1.0f && (vref - vramp) * vramp < 0.0f)
				; /* regen clamp: hold the deceleration ramp, the motor slows as fast as the bus allows */
			else if (!(dv > 0.0f) || g_ramp_bypass) /* bypass: the CANopen profile (or the master) ramps already */
				vramp = vref;
			else if (vref > vramp + dv)
				vramp += dv;
			else if (vref < vramp - dv)
				vramp -= dv;
			else
				vramp = vref;
			s_vel_ref_eff = vramp;
			const float ilim = g_i_vel; /* rated_current, capped by the temperature derating (temp.c) */
			g_iq_ref = pi_run(&g_pi_vel, vramp - s_vel, ilim);
			/* regen clamp: no braking integrator beyond what the current loop is allowed to deliver */
			const float bmax = s_regen_k * ilim;
			if (g_pi_vel.integ * s_vel < 0.0f && fabsf(g_pi_vel.integ) > bmax) g_pi_vel.integ = copysignf(bmax, g_pi_vel.integ);
		}
	}
	prev = lp;
	return ran;
}

/* ------------------------------------------------------------------ angle latency compensation */
/* The encoder age relative to the current sample comes from MT6835_Sample() every cycle (~4 us: the
 * last group of the read that ends just before the ADC). ENC_EXTRA_S is for delay the sensor adds
 * itself (its filter, BW register), unknown so far */
#define ENC_EXTRA_S 0.0f
/* the duty written now loads at the next bottom and is centred on the following top */
#define OUT_DELAY_S (1.0f / CTRL_FS_HZ + 0.44e-6f) /* ~40.4 us, current sample -> centre of the applied voltage */
#define ANGLE_COMP 1							   /* 0: use the raw encoder angle for both transforms */

/* ------------------------------------------------------------------ back-EMF (flux) observer */
/* Nonlinear flux observer (Ortega et al. 2011, the one VESC/ODrive use), stationary frame:
 *   x' = v - R*i + k * eta * (lambda^2 - |eta|^2),   eta = x - L*i = rotor flux,  k = gain / (2 lambda^2)
 * The angle of eta is the electrical angle at the current sample, the same instant theta_m refers to.
 * With g_params.obs_blend it replaces the encoder for commutation and speed above obs_lo rpm,
 * with a linear blend up to obs_hi (rpm, like hyb_lo/hyb_hi). Position always comes from the encoder. Tuning (params, 's'):
 * obs_gain (rad/s), obs_flux_tol, obs_err_max (deg electrical: leaves room for the encoder's own error,
 * nonlinearity ~+-5 and a mount slip of ~13 deg have been seen) */
#define OBS_LOCK_N 250		/* cycles (10 ms) both checks must hold before it gets any weight */
/* Once locked, a failing check only drops the observer when it persists: each check keeps a leaky count
 * (+1 per failing cycle, -1 per passing one) and drops at these levels. The flux check is the observer's
 * own (and the only one left without an encoder); the encoder check is slow on purpose, because the
 * encoder is not always the one that is wrong (mount slip, nonlinearity) */
#define OBS_FLUX_DROP_N 125 /* ~5 ms net of flux out of tolerance */
#define OBS_ENC_DROP_N 1250 /* ~50 ms net of disagreement with the encoder */

static float s_obs_xa, s_obs_xb;	/* stator flux estimate, Wb */
static float s_obs_ia, s_obs_ib;	/* currents at the previous sample, A */
static float s_obs_va, s_obs_vb;	/* last voltage written to the bridge, V */
static float s_obs_va1, s_obs_vb1;	/* the one written before it */
static float s_obs_kv = -1.0f;		/* kv, pole pairs and gain the constants below were computed from */
static uint8_t s_obs_pp;
static float s_obs_gain = -1.0f;
static float s_obs_lambda, s_obs_k; /* Wb peak phase (as cal_kv()), correction gain */
static float s_obs_inv_lambda, s_obs_inv_pp;
static uint16_t s_obs_good;			/* consecutive cycles both checks passed (up to OBS_LOCK_N) */
static uint16_t s_obs_flux_bad;		/* leaky counts of failing cycles, see OBS_FLUX_DROP_N */
static uint16_t s_obs_enc_bad;
static float s_obs_ratio = NAN;		/* |eta| / lambda, telemetry */
static float s_obs_err = NAN;		/* observer - encoder, turns electrical, telemetry */
static float s_obs_w;				/* blend weight, telemetry */

/* one step with the currents sampled now; returns 0 (and no angle) without R, L and kv */
static int obs_update(float i_a, float i_b, uint32_t* theta) {
	const uint32_t need = PF_R_VALID | PF_L_VALID;
	if ((g_params.flags & need) != need || !(g_params.kv > 0.0f)) {
		s_obs_ratio = NAN;
		return 0;
	}
	if (g_params.kv != s_obs_kv || g_params.pole_pairs != s_obs_pp) {
		s_obs_kv = g_params.kv;
		s_obs_pp = g_params.pole_pairs;
		s_obs_lambda = 60.0f / (2.0f * (float)M_PI * SQRT3 * (float)s_obs_pp * s_obs_kv);
		s_obs_inv_lambda = 1.0f / s_obs_lambda;
		s_obs_inv_pp = 1.0f / (float)s_obs_pp;
		s_obs_xa = s_obs_xb = 0.0f;
		s_obs_good = 0;
		s_obs_gain = -1.0f;
	}
	if (g_params.obs_gain != s_obs_gain) {
		s_obs_gain = g_params.obs_gain;
		s_obs_k = 0.5f * s_obs_gain / (s_obs_lambda * s_obs_lambda);
	}
	float r = 0.5f * (g_params.rd + g_params.rq);
	float l = 0.5f * (g_params.ld + g_params.lq);
	/* the interval since the previous sample ran on the previous command for about half of it and on the
	 * one before for the other half (a duty loads at the bottom and the samples are near the top) */
	float va = 0.5f * (s_obs_va + s_obs_va1) - r * 0.5f * (i_a + s_obs_ia);
	float vb = 0.5f * (s_obs_vb + s_obs_vb1) - r * 0.5f * (i_b + s_obs_ib);
	s_obs_ia = i_a;
	s_obs_ib = i_b;

	float ea = s_obs_xa - l * i_a, eb = s_obs_xb - l * i_b;
	float c = s_obs_k * (s_obs_lambda * s_obs_lambda - (ea * ea + eb * eb));
	s_obs_xa += (va + c * ea) * (1.0f / CTRL_FS_HZ);
	s_obs_xb += (vb + c * eb) * (1.0f / CTRL_FS_HZ);
	ea = s_obs_xa - l * i_a;
	eb = s_obs_xb - l * i_b;
	s_obs_ratio = sqrtf(ea * ea + eb * eb) * s_obs_inv_lambda;
	if (!(s_obs_ratio < 3.0f)) {
		/* far off (or NaN) the cubic correction overshoots in discrete time and runs away: restart from eta = 0 */
		s_obs_xa = l * i_a;
		s_obs_xb = l * i_b;
	}
	*theta = atan2_q32(eb, ea);
	return 1;
}

/* weight of the observer angle against the base angle (encoder, or HFI when sensorless). diff = observer - base
 * (Q32 electrical), vel = speed of the base in mechanical turn/s, blend = 0: run and log only,
 * agree = 0: the base is not a reference for the agreement check (sensorless above SL_AGREE_MAX_TURNS) */
static float obs_weight(int valid, uint32_t diff, float vel, int blend, int agree) {
	if (!valid) {
		s_obs_good = 0;
		s_obs_flux_bad = s_obs_enc_bad = 0;
		s_obs_err = NAN;
		s_obs_w = 0.0f;
		return 0.0f;
	}
	float d = (float)(int32_t)diff * (1.0f / 4294967296.0f);
	s_obs_err = d;
	int flux_ok = fabsf(s_obs_ratio - 1.0f) < g_params.obs_flux_tol;
	int enc_ok = !agree || fabsf(d) * 360.0f < g_params.obs_err_max;
	if (flux_ok) {
		if (s_obs_flux_bad) s_obs_flux_bad--;
	}
	else if (s_obs_flux_bad < UINT16_MAX)
		s_obs_flux_bad++;
	if (enc_ok) {
		if (s_obs_enc_bad) s_obs_enc_bad--;
	}
	else if (s_obs_enc_bad < UINT16_MAX)
		s_obs_enc_bad++;

	if (!(TIM1->BDTR & TIM_BDTR_MOE) || s_obs_flux_bad >= OBS_FLUX_DROP_N || s_obs_enc_bad >= OBS_ENC_DROP_N) {
		/* with MOE off the terminal voltage is not what was commanded: drop at once */
		s_obs_good = 0;
		s_obs_flux_bad = s_obs_enc_bad = 0; /* relocking needs OBS_LOCK_N clean cycles anyway */
	}
	else if (s_obs_good < OBS_LOCK_N) {
		s_obs_good = (flux_ok && enc_ok) ? s_obs_good + 1 : 0; /* locking: strict */
	}
	float w = 0.0f;
	if (blend && s_obs_good >= OBS_LOCK_N) {
		const float r = fabsf(vel) * 60.0f, lo = g_params.obs_lo, span = g_params.obs_hi - lo; /* rpm */
		if (span > 0.0f)
			w = (r - lo) / span;
		else
			w = (r >= lo) ? 1.0f : 0.0f;
		w = w < 0.0f ? 0.0f : w > 1.0f ? 1.0f
									   : w;
	}
	s_obs_w = w;
	return w;
}

/* Speed from the observer alone: a PLL (same bandwidth as the encoder one) on the observer's electrical
 * angle. Needs only a starting speed (seed, mechanical turn/s): the base's (encoder, or HFI when sensorless).
 * Blended into the speed with the same weight as the angle */
static uint32_t s_opll_ph; /* Q32 electrical */
static float s_opll_vel;   /* electrical turn/s */
static uint8_t s_opll_init;
static float s_obs_vel = NAN; /* turn/s mechanical, telemetry */

static void obs_pll(int valid, uint32_t th_obs, float seed) {
	if (!valid) {
		s_opll_init = 0;
		s_obs_vel = NAN;
		return;
	}
	if (!s_opll_init) {
		s_opll_ph = th_obs;
		s_opll_vel = seed * (float)g_params.pole_pairs;
		s_opll_init = 1;
	}
	float err = (float)(int32_t)(th_obs - s_opll_ph) * (1.0f / 4294967296.0f); /* electrical turns */
	s_opll_vel += PLL_KI_TS * err;
	s_opll_ph += (uint32_t)(int32_t)((s_opll_vel + PLL_KP * err) * (4294967296.0f / CTRL_FS_HZ));
	s_obs_vel = s_opll_vel * s_obs_inv_pp; /* valid: obs_update() has set it */
}

/* time since the ADC sampled the currents (CC4 on the way up), from the TIM1 counter */
static inline float since_current_sample_s(void) {
	int32_t arr = (int32_t)TIM1->ARR, smp = (int32_t)TIM1->CCR4, cnt = (int32_t)TIM1->CNT;
	int32_t d = (TIM1->CR1 & TIM_CR1_DIR) ? (arr - smp) + (arr - cnt) : cnt - smp;
	return (float)d * (1.0f / 170e6f);
}

/* ------------------------------------------------------------------ trips (calib.h) */
volatile uint8_t g_trip;
volatile uint32_t g_ov_resumes;

/* detects overvoltage/overcurrent and decides what the trip does. Returns 1 while the motor coasts at zero
 * current (CTRL_RUN). Outside CTRL_RUN a trip switches the bridge off straight away: CTRL_OFF/CTRL_CAL would put
 * the zero vector (short-brake) or an open-loop voltage on it. An OV coast resumes by itself once the bus is
 * back down (vbus_resume, OV_RESUME_N). The ISR never writes g_mode */
/* the trip and the coast after it, from trip_check(): t = the trip just detected, or TRIP_NONE while coasting. In
 * flash to leave CCM room: it runs only on those cycles */
static __attribute__((noinline)) int trip_coast(uint8_t t, float ia, int oc, ctrl_mode_t mode) {
	static uint8_t lost_n, res_n;
	static float id_save, iq_save; /* references when the trip hit, for the resume */
	const float imax = g_params.max_current;
	if (t != TRIP_NONE) {
		g_trip = t;
		lost_n = res_n = 0;
		id_save = g_id_ref;
		iq_save = g_iq_ref;
		if (mode != CTRL_RUN) {
			bridge_trip_off();
			return 0;
		}
	}
	if (mode != CTRL_RUN || g_trip_moe) return 0; /* bridge off, or the watchdog ended the coast */
	lost_n = oc ? (lost_n < 255 ? lost_n + 1 : lost_n) : 0;
	if ((imax > 0.0f && ia > OC_HARD * imax) || lost_n >= OC_LOST_N) { /* zero current did not take: the loop lost control */
		bridge_trip_off();
		return 0;
	}
	if (g_trip == TRIP_OV) {
		res_n = (g_vin < g_params.vbus_max - g_params.vbus_resume) ? (res_n < 255 ? res_n + 1 : res_n) : 0;
		if (res_n >= OV_RESUME_N) { /* bus back down: carry on. The speed/position loops pick up bumplessly */
			g_id_ref = id_save;
			if (g_loop == LOOP_CURRENT) g_iq_ref = iq_save; /* the outer loops start from the present (zero) current */
			g_trip = TRIP_NONE;
			g_ov_resumes++;
			return 0;
		}
	}
	return 1;
}

static inline int trip_check(float id, float iq, ctrl_mode_t mode) {
	static uint8_t ov_n, oc_n;
	const float imax = g_params.max_current;
	const float ia = fabsf(id) > fabsf(iq) ? fabsf(id) : fabsf(iq);
	const int oc = imax > 0.0f && ia > imax;
	if (g_trip != TRIP_NONE) return trip_coast(TRIP_NONE, ia, oc, mode);
	ov_n = (g_params.vbus_max > 0.0f && g_vin > g_params.vbus_max) ? (ov_n < 255 ? ov_n + 1 : ov_n) : 0;
	oc_n = oc ? (oc_n < 255 ? oc_n + 1 : oc_n) : 0;
	uint8_t t = ov_n >= OV_TRIP_N ? TRIP_OV : oc_n >= OC_TRIP_N ? TRIP_OC : TRIP_NONE;
	if (t == TRIP_NONE) return 0;
	ov_n = oc_n = 0;
	return trip_coast(t, ia, oc, mode);
}

/* Hall angle sources, for the telemetry (set in currentLoop()) */
static float s_hall_err = NAN; /* Hall - encoder, electrical turns (ang_src 3) */
static float s_hall_vel;	   /* Hall speed, turn/s */

/* telemetry, once every 10 cycles. The ISR only fills in the values; tlm_finish() adds the sum and queues the
 * frame from the link IRQ (priority 1). Doing all of it here made these the longest cycles. In flash, like
 * tlm_finish(): CCM is nearly full, and these cycles have room (the outer loops never run in them). s_tlm_full hands
 * the frame over: set here, cleared there; a frame still waiting is not overwritten */
static volatile uint8_t s_tlm_full;

static void tlm_finish(void) {
	telemetry.sum = frame_sum(&telemetry);
	if (!link_tx(&telemetry, sizeof(telemetry))) g_tlm_drop++;
	s_tlm_full = 0;
}

static __attribute__((noinline)) void send_telemetry(uint32_t ang, float id, float iq, ctrl_mode_t mode) {
	if (s_tlm_full) {
		g_tlm_drop++;
		return;
	}
	telemetry.seq = seq;
	telemetry.v[0] = (float)ang * (360.0f / 2097152.0f);
	telemetry.v[1] = g_vin;
	/* HFI - reference (encoder; Hall in Hall + HFI), deg electrical, NaN unless HFI tracks. Hall: Hall - encoder */
	telemetry.v[2] = (g_params.ang_src == ANG_HALL ? s_hall_err : g_hfi_err) * 360.0f;
	telemetry.v[3] = g_hfi_rpm;			  /* HFI PLL speed; NaN unless HFI tracks */
	telemetry.v[4] = g_hfi_amp;			  /* HF current step along the injection axis, A; NaN with HFI off */
	telemetry.v[5] = id;				  /* with HFI on: the fundamental, what the PIs see */
	telemetry.v[6] = iq;
	telemetry.v[7] = g_rpm;
	telemetry.v[8] = s_vel_ref_eff * 60.0f; /* NaN unless a speed/position loop is active */
	telemetry.v[9] = g_pos;
	telemetry.v[10] = (mode == CTRL_RUN && g_loop == LOOP_POS) ? q32_to_f(s_pos_ref) : NAN;
	telemetry.v[11] = s_obs_err * 360.0f; /* observer - base (encoder, HFI when sensorless), deg electrical; NaN without R, L, kv */
	telemetry.v[12] = s_obs_ratio;		  /* |rotor flux| / lambda, 1 when converged */
	telemetry.v[13] = s_obs_w;			  /* observer weight in the commutation angle and the speed */
	telemetry.v[14] = s_obs_vel * 60.0f;  /* rpm from the observer PLL alone; NaN without the observer */
	telemetry.v[15] = (g_params.ang_src >= ANG_HALL ? s_hall_vel : s_pll_vel) * 60.0f; /* rpm from the encoder PLL alone (Hall sources: the Halls); v[7] is the blend */
	s_tlm_full = 1;
	link_defer(tlm_finish);
}
/* ------------------------------------------------------------------ Hall angle sources (ang_src 3, 4) */
/* Hall + HFI: HFI may stray this far outside the Hall sector (sensor placement, its own error) before it counts
 * as slipped; after HYB_SLIP_N such cycles it is put back on the Hall angle. That only costs accuracy, it never
 * stops the motor: the Hall angle is always there */
#define HYB_MARGIN ((uint32_t)(20.0 / 360.0 * 4294967296.0))
#define HYB_SLIP_N 50 /* 2 ms */
volatile uint32_t g_hyb_reseeds; /* those re-seeds, diagnostics */
static pos_q32_t s_hall_pos;	 /* the base angle accumulated, mechanical Q32.32 turns, motor direction */
static uint32_t s_hall_th_prev;
static int32_t s_hall_rem; /* electrical Q32 not yet carried into s_hall_pos (below one pole pair) */
static uint8_t s_hall_pos_on;

/* the position of the Hall sources: advances with the base angle, electrical -> mechanical with int32
 * maths only. Starts where the position was, so switching the source does not move it */
static inline void hall_pos_step(uint32_t th) {
	if (!s_hall_pos_on) {
		s_hall_pos = s_pos + s_home;
		s_hall_th_prev = th;
		s_hall_rem = 0;
		s_hall_pos_on = 1;
		return;
	}
	const int32_t pp = g_params.pole_pairs ? g_params.pole_pairs : 1;
	const int32_t d = (int32_t)(th - s_hall_th_prev) + s_hall_rem;
	s_hall_th_prev = th;
	const int32_t q = d / pp; /* one electrical turn (2^32) is 2^32 / pp of a mechanical one */
	s_hall_rem = d - q * pp;
	s_hall_pos += q;
}

/* Hall + HFI: weight of the Hall angle against HFI, by speed (mechanical turn/s) */
static inline float hyb_weight(float vel) {
	const float r = fabsf(vel) * 60.0f, lo = g_params.hyb_lo, hi = g_params.hyb_hi;
	if (r <= lo) return 0.0f;
	if (r >= hi) return 1.0f;
	return (r - lo) / (hi - lo);
}

void currentLoop(void) {
	static float age_cur; /* encoder sample -> current sample */
	uint32_t c0 = DWT->CYCCNT;
	float age;
	int fresh = MT6835_Sample(&hMT6835, &age); /* last good group of this period's burst read */
	age_cur = fresh ? age + ENC_EXTRA_S : age_cur + 1.0f / CTRL_FS_HZ;
	if (fresh)
		g_enc_lost_n = 0;
	else if (g_enc_lost_n < UINT16_MAX)
		g_enc_lost_n++;
	uint32_t ang = hMT6835.angle; /* one snapshot for the whole cycle */
	/* turns and angle are only written by MT6835_Sample(), earlier in this same ISR */
	const int64_t raw = (int64_t)hMT6835.turns * 2097152 + (int64_t)ang;
	const int64_t pe = (g_params.enc_dir > 0) ? raw : -raw; /* encoder counts, motor direction */
	const uint8_t src = g_params.ang_src;
	const int hl = src >= ANG_HALL; /* Hall or Hall + HFI */
	const int hyb = src == ANG_HALL_HFI;
	/* the Hall sources' position is the one accumulated last cycle (the base angle comes further down) */
	motion_update((hl && s_hall_pos_on) ? s_hall_pos : pe * 2048, (uint32_t)pe << 11, fresh,
				  age_cur + since_current_sample_s()); /* the PLL works in "now" time */

	float i_alpha, i_beta, id, iq;
	clarke(g_cur[0], g_cur[1], g_cur[2], &i_alpha, &i_beta);
	uint32_t th_obs = 0;
	int obs = obs_update(i_alpha, i_beta, &th_obs); /* runs in every mode so it is converged when needed */

	/* angle source (ang_src). Sensorless: HFI is the base for commutation, speed and the observer's references
	 * (seed speed, back-EMF level, agreement check); the encoder is only logged. Encoder modes: the encoder is
	 * the base, and the observer blends in only in ANG_ENC_OBS. Hall: the interpolated Hall angle. Hall + HFI:
	 * HFI below hyb_lo, crossfading to the Halls by hyb_hi. Position comes from the encoder, or from the base
	 * angle accumulated in the Hall sources */
	const int sl = src == ANG_SENSORLESS;
	uint32_t th_hfi;
	float vel_hfi;
	const int hfi_ok = hfi_estimate(&th_hfi, &vel_hfi); /* always fills both, valid or not */
	uint32_t th_hall;
	float vel_hall;
	hall_update(&th_hall, &vel_hall); /* in every mode: the state and the speed stay live (calibration, re-arm) */

	/* encoder angle, advanced by the known delays to the current sample. Blended with the observer by
	 * speed, it gives theta_m = rotor angle when the currents were sampled (Park); theta_o = rotor angle
	 * while the new voltage is applied (inverse Park). Forced during calibration */
	float pp = (float)g_params.pole_pairs;
	float we_enc = s_pll_vel * pp * 4294967296.0f; /* electrical Q32 per second, encoder */
	uint32_t th_enc = elec_angle(ang);
#if ANGLE_COMP
	th_enc += (uint32_t)(int32_t)(we_enc * age_cur);
#endif
	uint32_t th_base = th_enc;
	float vel_base = s_pll_vel;
	float hw = 0.0f; /* Hall + HFI: weight of the Hall angle */
	if (sl) {
		th_base = th_hfi;
		vel_base = vel_hfi;
	}
	else if (hl) {
		th_base = th_hall;
		vel_base = vel_hall;
		if (hyb) {
			hw = hyb_weight(vel_hall);
			if (hfi_ok && hw < 1.0f) {
				/* guard: HFI must stay in the Hall sector (it locks on d or -d, only the Halls tell them apart) */
				static uint16_t out_n;
				if (hall_in_sector(th_hfi, HYB_MARGIN))
					out_n = 0;
				else if (++out_n >= HYB_SLIP_N) {
					hfi_reseed(th_hall, vel_hall);
					g_hyb_reseeds++;
					out_n = 0;
					th_hfi = th_hall;
					vel_hfi = vel_hall;
				}
				th_base = th_hfi + (uint32_t)(int32_t)(hw * (float)(int32_t)(th_hall - th_hfi)); /* shortest way round */
				vel_base = vel_hfi + hw * (vel_hall - vel_hfi);
			}
		}
		hall_pos_step(th_base);
	}
	else
		s_hall_pos_on = 0;
	s_hall_vel = vel_hall;
	s_hall_err = (src == ANG_HALL && g_enc_lost_n < ENC_LOST_N) ? (float)(int32_t)(th_hall - th_enc) * (1.0f / 4294967296.0f) : NAN;
	obs_pll(obs, th_obs, vel_base);
	/* sensorless always blends the observer in (HFI alone cannot reach full speed); ENCODER never does */
	const int blend = sl || ((src == ANG_ENC_OBS || hl) && g_params.obs_blend);
	/* the observer's agreement check and speed threshold use the base: HFI when sensorless, else the encoder or the Halls */
	const int agree = !sl || fabsf(vel_base) < SL_AGREE_MAX_TURNS; /* sensorless: HFI is wrong at speed */
	float w = obs_weight(obs, th_obs - th_base, vel_base, blend, agree);
	/* injection off once the observer (Hall + HFI: or the Halls) has it all, back on below 90 % (hysteresis: w is
	 * noisy at the edge) */
	static uint8_t hfi_pause;
	if (w >= 1.0f || hw >= 1.0f)
		hfi_pause = 1;
	else if (w < 0.9f && hw < 0.9f)
		hfi_pause = 0;
	s_vel = (w > 0.0f) ? vel_base + w * (s_obs_vel - vel_base) : vel_base; /* s_obs_vel is NaN when invalid */
	g_vel = s_vel;
	g_rpm = s_vel * 60.0f;
#if ANGLE_COMP
	uint32_t out_adv = (uint32_t)(int32_t)(s_vel * pp * 4294967296.0f * OUT_DELAY_S);
#else
	uint32_t out_adv = 0;
#endif
	uint32_t theta_m, theta_o;
	if (g_mode == CTRL_CAL) {
		theta_m = theta_o = g_theta_cmd;
	}
	else {
		theta_m = th_base + (uint32_t)(int32_t)(w * (float)(int32_t)(th_obs - th_base)); /* shortest way round */
		theta_o = theta_m + out_adv;
	}
	float sin_ang, cos_ang, sin_o, cos_o;
	sincos_q31(theta_m, &sin_ang, &cos_ang);
	sincos_q31(theta_o, &sin_o, &cos_o);

	/* measurement */
	park(i_alpha, i_beta, sin_ang, cos_ang, &id, &iq);
	g_id = id; /* unfiltered: the overcurrent checks see the injection ripple too */
	g_iq = iq;

	/* trips (g_trip): coast at zero current in CTRL_RUN, bridge off otherwise or when that fails */
	ctrl_mode_t mode = g_mode;
	const int coast = trip_check(id, iq, mode);
	if (coast) {
		g_id_ref = 0.0f;
		g_iq_ref = 0.0f;
	}
	else if (g_trip)
		mode = CTRL_OFF; /* the bridge is off, or the coast has ended */

	/* high-frequency injection: voltage to add, and the PIs get the fundamental only */
	float inj_a, inj_b;
	hfi_out_t hf = hfi_step(mode == CTRL_RUN, sl, hfi_pause, s_vel, i_alpha, i_beta, theta_m, hyb ? th_hall : th_enc, &inj_a, &inj_b);
	if (hf == HFI_INJECT) hfi_filter(&id, &iq);
	const int hold = hf == HFI_HOLD; /* polarity pulses / sensorless start: PIs and outer loops wait */
	/* sensorless: count the cycles HFI is not tracking (the watchdog stops the motor after SL_LOST_N). The
	 * held cycles and the saliency map (HFI_MAP, no tracking by design) do not count */
	if (sl && mode == CTRL_RUN && !hold && g_hfi_cmd != HFI_MAP && !hfi_ok) {
		if (g_sl_lost_n < UINT16_MAX) g_sl_lost_n++;
	}
	else
		g_sl_lost_n = 0;

	/* voltage command in volts. SVPWM() spans 0..ARR - ZERO_TIME, so full scale is that share of the bus:
	 * with g_vin the applied volts were ~3 % below the command (kv read ~3 % low, R high) */
	float vin = (g_vin > 1.0f ? g_vin : 1.0f) * duty_k;
	float v_d = 0.0f, v_q = 0.0f; /* CTRL_OFF: zero volts, bridge stays enabled */
	/* regen clamp: braking current shrinks to zero across the vbus_clamp band below vbus_max (0 = off) */
	float rk = 1.0f;
	if (g_params.vbus_max > 0.0f && g_params.vbus_clamp > 0.0f && g_vin > g_params.vbus_max - g_params.vbus_clamp) {
		rk = (g_params.vbus_max - g_vin) / g_params.vbus_clamp; /* inside the band only: no divide on most cycles */
		rk = rk < 0.0f ? 0.0f : rk;
	}
	s_regen_k = rk;
	const int outer_ran = outer_loops((hold || coast) ? CTRL_OFF : mode); /* held: bumpless from the present state after */
	if (mode == CTRL_RUN) {
		if (!hold) {
			float vmax = (0.9f * INV_SQRT3) * vin - (hf == HFI_INJECT ? g_params.hfi_v : 0.0f);
			float iq_ref = g_iq_ref;
			if (iq_ref * s_vel < 0.0f) iq_ref *= rk; /* braking: only what the bus can take */
			pi_current_step(id, iq, iq_ref, vmax > 0.0f ? vmax : 0.0f, &v_d, &v_q);
		}
	}
	else {
		pi_reset(&g_pi_d); /* start from zero on the next CTRL_RUN */
		pi_reset(&g_pi_q);
		if (mode == CTRL_CAL) {
			v_d = g_vd_cmd;
			v_q = g_vq_cmd;
		}
	}
	/* ~0.4 ms low-pass, read by slow routines in main (kv calibration back-EMF) */
	g_vd_f += 0.1f * (v_d - g_vd_f);
	g_vq_f += 0.1f * (v_q - g_vq_f);
	g_iq_f += 0.1f * (iq - g_iq_f);

	/* volts -> per-unit of Vdc/sqrt(3), add the injection (already alpha-beta), then limit the vector
	 * (keeps its direction) */
	float k = SQRT3 / vin;
	float v_alpha, v_beta;
	ipark(v_d * k, v_q * k, sin_o, cos_o, &v_alpha, &v_beta);
	v_alpha += inj_a * k;
	v_beta += inj_b * k;
	/* beyond 1 the phases clip and the observer would integrate a voltage that was never applied */
	float m2 = v_alpha * v_alpha + v_beta * v_beta;
	if (m2 > 1.0f) {
		float sc = 1.0f / sqrtf(m2); /* build with -fno-math-errno so this is one vsqrt */
		v_alpha *= sc;
		v_beta *= sc;
	}
	int written = SVPWM(v_alpha, v_beta); /* apply first, log afterwards: less delay between measurement and output */
	s_obs_va1 = s_obs_va;				  /* when nothing was written the previous duties stay on */
	s_obs_vb1 = s_obs_vb;
	if (written) {
		s_obs_va = v_alpha * vin * INV_SQRT3;
		s_obs_vb = v_beta * vin * INV_SQRT3;
	}

	/* decay/step recorder used by the Ld/Lq calibrations */
	if (g_rec_state == 1) {
		g_rec_n = 0;
		g_rec_state = 2;
	}
	if (g_rec_state == 2) {
		g_rec[g_rec_n++] = g_rec_use_q ? iq : id;
		if (g_rec_n >= REC_N) g_rec_state = 3;
	}

	/* telemetry */
	/* never on the cycle the outer loops ran: the two together were the longest cycles */
	if (++cycles_since_last_frame >= 10 && !outer_ran) {
		cycles_since_last_frame = 0;
		seq++;
		if (link_tx_ready()) send_telemetry(ang, id, iq, mode); /* UART: main may be sending a reply, skip a frame. USB: no host */
	}

	uint32_t dc = DWT->CYCCNT - c0;
	g_loop_cyc = dc;
	if (dc > g_loop_cyc_max) g_loop_cyc_max = dc;
}
