alanhpereira/fluxdrive-g4/Core/Src/curSnsCtrl.c

/* ADC callback -> currentLoop(): -O2 even in a size-optimized (-Os) build */
#pragma GCC optimize("O2")

#include "curSnsCtrl.h"
#include "adc.h"
#include "dac.h"
#include "opamp.h"
#include "params.h"
#include "temp.h" /* temp_init() */

volatile int16_t cur_raw[3];
volatile uint16_t vin_raw;
volatile float g_cur[3];
volatile float g_vin;

static int16_t cur_offset[3]; /* ADC counts subtracted in the callback: 2048 + g_cs_off[i] */
int16_t g_cs_off[3];
volatile uint8_t g_cs_off_src;

float g_curMult;
float g_vinMult;
float g_vdda = VDDA;

extern void currentLoop();

void disableCS() {
	HAL_ADCEx_InjectedStop_IT(&hadc1);
	HAL_ADCEx_InjectedStop_IT(&hadc2);
}

void cs_set_offsets(const int16_t off[3]) {
	for (int i = 0; i < 3; i++) {
		g_cs_off[i] = off[i];
		cur_offset[i] = (int16_t)(2048 + off[i]); /* one 16-bit store each: the callback never sees half of it */
	}
}

/* the stored offsets once CAL_CUR_OFF has measured them, else the bench board's */
static void cs_fallback(void) {
	static const int16_t k_def[3] = CS_OFF_DEFAULT;
	const int stored = (g_params.flags & PF_CUR_CAL_VALID) != 0;
	cs_set_offsets(stored ? g_params.cur_off : k_def);
	g_cs_off_src = stored ? CS_OFF_SRC_STORED : CS_OFF_SRC_DEFAULT;
}

int cs_measure_offsets(int16_t out[3], int16_t spread[3]) {
	int32_t acc[3] = {0, 0, 0};
	int16_t lo[3] = {INT16_MAX, INT16_MAX, INT16_MAX}, hi[3] = {INT16_MIN, INT16_MIN, INT16_MIN};
	for (int n = 0; n < CS_OFF_N; n++) {
		HAL_Delay(1);
		for (int i = 0; i < 3; i++) {
			int16_t r = (int16_t)(cur_raw[i] + cur_offset[i]); /* back to the raw ADC value */
			acc[i] += r;
			if (r < lo[i]) lo[i] = r;
			if (r > hi[i]) hi[i] = r;
		}
	}
	int ok = 1;
	for (int i = 0; i < 3; i++) {
		int32_t a = acc[i] + (acc[i] >= 0 ? CS_OFF_N / 2 : -CS_OFF_N / 2); /* rounded */
		out[i] = (int16_t)(a / CS_OFF_N - 2048);
		spread[i] = (int16_t)(hi[i] - lo[i]);
		if (out[i] > CS_OFF_ABS_MAX || out[i] < -CS_OFF_ABS_MAX || spread[i] > CS_OFF_SPREAD_MAX) ok = 0;
	}
	return ok;
}

void cs_boot_offsets(void) {
	int16_t m[3], sp[3];
	if (!cs_measure_offsets(m, sp)) return;
	for (int i = 0; i < 3; i++) {
		int d = m[i] - g_cs_off[i];
		if (d > CS_OFF_DEV_MAX || d < -CS_OFF_DEV_MAX) return; /* rotor turning, or a bad fallback: keep it */
	}
	cs_set_offsets(m);
	g_cs_off_src = CS_OFF_SRC_BOOT;
}

/* VDDA from the internal reference and its factory reading (taken at 3.0 V), once at boot; VDDA if it fails or
 * is implausible. ADC1 regular channel, after the calibration: the VREFINT path can only be switched on while
 * both ADCs are disabled, and HAL_ADC_Stop() leaves ADC1 disabled for the injected start */
static float cs_vdda(void) {
	ADC_ChannelConfTypeDef c = {0};
	/* the die temperature sensor path too, in the same window (temp.c converts it later) */
	c.Channel = ADC_CHANNEL_TEMPSENSOR_ADC1;
	c.Rank = ADC_REGULAR_RANK_1;
	c.SamplingTime = ADC_SAMPLETIME_247CYCLES_5;
	c.SingleDiff = ADC_SINGLE_ENDED;
	c.OffsetNumber = ADC_OFFSET_NONE;
	(void)HAL_ADC_ConfigChannel(&hadc1, &c); /* failed: temp_init() sees the path off, die temperature NaN */
	c.Channel = ADC_CHANNEL_VREFINT;
	c.Rank = ADC_REGULAR_RANK_1;
	c.SamplingTime = ADC_SAMPLETIME_640CYCLES_5; /* 15 us, VREFINT needs >= 4 us */
	c.SingleDiff = ADC_SINGLE_ENDED;
	c.OffsetNumber = ADC_OFFSET_NONE;
	if (HAL_ADC_ConfigChannel(&hadc1, &c) != HAL_OK) return VDDA;
	uint32_t acc = 0;
	for (int n = 0; n < 2 + CS_VREF_N; n++) {
		if (HAL_ADC_Start(&hadc1) != HAL_OK || HAL_ADC_PollForConversion(&hadc1, 1) != HAL_OK) {
			HAL_ADC_Stop(&hadc1);
			return VDDA;
		}
		if (n >= 2) acc += HAL_ADC_GetValue(&hadc1); /* the first two let the reference settle */
	}
	HAL_ADC_Stop(&hadc1);
	if (acc == 0) return VDDA;
	const float v = 3.0f * (float)*VREFINT_CAL_ADDR * (float)CS_VREF_N / (float)acc;
	return (v > 3.0f && v < 3.6f) ? v : VDDA;
}

HAL_StatusTypeDef initCS() {
	HAL_StatusTypeDef status;
	cs_fallback();

	HAL_GPIO_WritePin(GPIOE, GPIO_PIN_7, GPIO_PIN_SET);

	HAL_DAC_Start(&hdac1, DAC_CHANNEL_1);
	HAL_DAC_SetValue(&hdac1, DAC1_CHANNEL_1, DAC_ALIGN_12B_R, 0x800);
	status = HAL_ADC_Start(&hadc1);
	if (status != HAL_OK) {
		disableCS();
		return status;
	}
	status = HAL_ADC_Start(&hadc2);
	if (status != HAL_OK) {
		disableCS();
		return status;
	}
	status = HAL_OPAMP_Start(&hopamp1);
	if (status != HAL_OK) {
		disableCS();
		return status;
	}
	status = HAL_OPAMP_Start(&hopamp2);
	if (status != HAL_OK) {
		disableCS();
		return status;
	}
	status = HAL_OPAMP_Start(&hopamp3);
	if (status != HAL_OK) {
		disableCS();
		return status;
	}
	status = HAL_ADCEx_Calibration_Start(&hadc1, ADC_SINGLE_ENDED);
	if (status != HAL_OK) {
		disableCS();
		return status;
	}
	status = HAL_ADCEx_Calibration_Start(&hadc2, ADC_SINGLE_ENDED);
	if (status != HAL_OK) {
		disableCS();
		return status;
	}
	g_vdda = cs_vdda();
	g_curMult = -g_vdda / (2.0f * 4095.0f * CS_GAIN * CS_SHUNT);
	g_vinMult = g_vdda * (VIN_RL + VIN_RH) / (4095.0f * VIN_RL);
	temp_init(); /* regular-channel sample times: only while JADSTART = 0 */

	status = HAL_ADCEx_InjectedStart_IT(&hadc1);
	if (status != HAL_OK) {
		disableCS();
		return status;
	}
	status = HAL_ADCEx_InjectedStart_IT(&hadc2);
	if (status != HAL_OK) {
		disableCS();
		return status;
	}
	/* one interrupt per cycle, at the end of ADC2's sequence: cs_adc_irq() */
	ADC1->IER &= ~(ADC_IER_JEOCIE | ADC_IER_JEOSIE);
	ADC2->IER = (ADC2->IER & ~ADC_IER_JEOCIE) | ADC_IER_JEOSIE;
	return HAL_OK;
}

/* ADC1_2_IRQHandler, from its USER CODE section, which returns before the HAL handlers. Both ADCs convert a
 * two-rank injected sequence on the same CC4 trigger, so one interrupt at the end of ADC2's sequence (JEOS)
 * reads all four results. HAL_ADC_IRQHandler ran on the first conversion of each (JEOC, from the .ioc's
 * EOC_SINGLE_CONV) and took ~3.6 us before currentLoop() started: measured 4.5 us after the trigger, now 2.0-2.5 us */
void cs_adc_irq(void) {
	ADC2->ISR = ADC_ISR_JEOC | ADC_ISR_JEOS; /* write 1 to clear */
	for (int n = 0; !(ADC1->ISR & ADC_ISR_JEOS) && n < 100; n++) {
	} /* same clock and trigger: ADC1 is done too, or a few cycles away */
	ADC1->ISR = ADC_ISR_JEOC | ADC_ISR_JEOS;
	cur_raw[0] = (int16_t)(ADC1->JDR1 - cur_offset[0]);
	cur_raw[2] = (int16_t)(ADC1->JDR2 - cur_offset[2]);
	cur_raw[1] = (int16_t)(ADC2->JDR1 - cur_offset[1]);
	vin_raw = (uint16_t)ADC2->JDR2;
	g_cur[0] = cur_raw[0] * g_curMult;
	g_cur[1] = cur_raw[1] * g_curMult;
	g_cur[2] = cur_raw[2] * g_curMult;
	g_vin = vin_raw * g_vinMult;
	currentLoop();
}
