alanhpereira/fluxdrive-g4/Core/Inc/motorCtrl.h

#ifndef MOTORCTRL_H
#define MOTORCTRL_H

#include "stm32g4xx_hal.h"
#include "bridgeCtrl.h"
#include "curSnsCtrl.h"

void disableMotor();
HAL_StatusTypeDef initMotor();
void currentLoop();
int SVPWM(float alpha, float beta);

extern volatile uint32_t g_loop_cyc, g_loop_cyc_max; /* currentLoop() run time in CPU cycles (170 per us) */
extern volatile uint32_t g_hyb_reseeds;			  /* Hall + HFI: HFI put back on the Hall angle after leaving its sector */
extern volatile uint32_t g_tlm_drop;				  /* telemetry frames dropped on a full link queue */
#endif
