alanhpereira/fluxdrive-g4/(commit log)

2026-10-08 Feat: add base file for mt6835 encoder
2026-10-08 Fix: spi parameters
2026-10-09 Feat: working mt6835 driver
2026-10-09 Feat: basic fet control
2026-10-10 Feat: add svpwm drivers
2026-10-11 Feat: add serial interface for parameter setting and soem calibration routines
2026-10-11 Feat: working position and velocity loops
2026-10-11 Feat: better encoder synchronization
2026-10-12 Feat: sensorless angle source with encoder modes
    Add ang_src (object 0x4011): 0 encoder only, 1 encoder with observer
    blend, 2 sensorless (HFI, observer above olo, no encoder in the loop,
    position mode refused).
    Sensorless bring-up needs no encoder: the saliency map uses a frozen
    reference and stores the magnitude, polarity is decided by the pulses,
    kv reads speed from HFI. Safety stop ST_HFI_LOST after 50 ms without
    HFI tracking. The observer agreement check is skipped above ~600 rpm.
    hfi_mode is 0/1 only. PARAM_VERSION 6 (angsrc added, scale params
    removed). set_off() clears the HFI speed.
2026-10-17 Feat: CANopen node (CiA 301) on FDCAN1
    CANopenNode v4 (vendored, CANopen/CANopenNode) with an STM32G4 FDCAN port
    and a 1 kHz TIM7 tick at priority 2 running CO_process, SYNC and PDOs.
    Object dictionary from driverTCC.xdd (CANopenEditor), exported to
    CANopen/od and software/driverTCC.eds. Node 1 at 1 Mbit/s for now.
    FDCAN timing fixed to 1 Mbit/s (prescaler 10, 13 + 3 tq) with
    auto-retransmission, in the .ioc and fdcan.c.
    Verified on hardware: boot-up, heartbeat, SDO reads of the 301
    objects, NMT start / pre-operational.
2026-10-17 Feat: CAN node ID and bit rate over the config link
    Comm record in flash pages 60-61 (co_store.c, A/B + CRC32): node ID, bit
    rate and OD_PERSIST_COMM, with an OD layout signature so a re-exported
    OD falls back to its defaults. A communication reset reloads it.
    0x1010/0x1011 over SDO are deferred to the main loop (bridge off).
    SAVE writes both records; flash_write_page()/flash_crc32() shared with
    params.c.
    Objects 0x4040 (node ID, bit rate, in use, apply) and 0x4041 (NMT state,
    CAN error bits, frame counters); plotter CAN group, Statistics line and
    "Apply CAN settings" button.
    Python bytecode is no longer tracked.
    Verified on hardware: node 5 via apply, SAVE + reboot, 0x1017 stored
    over SD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
2026-10-17 Feat: CiA 402 and native objects in the CANopen OD
    driverTCC.xdd gains the CiA 402 objects (controlword/statusword, modes,
    targets, actual values, windows, profile ramps, homing, limits;
    settings in storage group PERSIST_APP) and the native records
    0x4000-0x4041 generated from objects.py, plus the default PDO mapping.
    Units: inc (2^21/rev), inc/s, inc/s^2, per mille of rated, mV.
    Native objects are served over SDO through an OD extension that calls
    objdict's od_read_fast()/od_write(), so range checks and side effects
    match the USB protocol (od_read_fast never does the I2C status read).
    The comm record also keeps OD_PERSIST_APP (0x1010:3, 0x1011:3 restores
    the 402 defaults only) and is stre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
2026-10-17 Feat: CiA 402 state machine with CSV and CST
    co402.c: FSA on 0x6040/0x6041 (option codes 605A-605D, halt, fault
    reset), modes CSV and CST with bumpless switching, faults to 0x603F +
    EMCY + 0x1001, master loss (heartbeat consumer / NMT) with the 0x6007
    reaction, 0x6060 mode check and 0x6073/6075/6076/6080 as views of the
    motor parameters. The state machine runs in the main loop through
    calib.c's new drive_check/enter/coast/trip_reset; the 1 kHz tick only
    streams references and fills the actual values and statusword.
    While the master has the motor, USB run/cal/home/save/reboot get
    ST_CAN_ACTIVE; a USB STOP takes it back (fault 0xFF01). ISR: speed
    ramp bypass for the CANopen modes, atomic posi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
2026-10-17 Feat: CiA 402 profile velocity, homing and profile position
    - PV: ramp to 60FF at 6083/6084, limited by 607F and vlim; halt holds
    zero. Target reached from a 10 ms filtered speed (606D/606E), speed
    zero from 606F/6070.
    - 606D/606F declared UNSIGNED32 (CiA 402: UNSIGNED16, at most 1.9 rpm
    with 2^21 inc/rev); 606D default 10 rpm.
    - HM: methods 37 and 35 (home here), others refused. The position at
    home becomes -607C (g_home_pos in the ISR; USB HOME keeps 0).
    - PP: 1 kHz trapezoid generator handed to the ISR like CSP. Set-point
    handshake (bits 4/5/6, one buffered set-point), target reached
    (6067/6068), halt and resume, 607D limits, following error.
    - A disable/shutdown ramp cancelle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
2026-10-17 Feat: CANopen PC interface (plotter tab, core, test runner)
    software/co_link.py: Qt-free CANopen master on python-can + canopen:
    SDO with retries and abort texts, NMT, heartbeat watch, EMCY log, PDO
    samples, CiA 402 commands and statusword decoding, PP/HM helpers, and a
    CSP/CSV/CST set-point streamer on a software SYNC producer. It patches
    python-can's SLCAN driver on Windows (byte-wise reads and a 50 ms flush
    sleep made replies 50-300 ms late).
    software/cotest.py + cotests/: the 17 seed tests from the handoff,
    headless or from the GUI, results in software/cotest_runs/.
    software/canopen_tab.py: the CANopen tab (bus, drive state, mode panels,
    streamer, TPDO plots, OD browser, PDO mapping, t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
2026-10-17 Fix: position-mode feed-forward dips (PP 500 Hz noise, CSP clicks)
    The ISR cleared the speed feed-forward in the last cycle of each
    segment, and a CSP target arriving late (the 1 ms tick grid, master
    jitter) stopped the reference. Measured: 500 Hz dips of the full
    feed-forward in PP, ~1 ms speed-reference dips and 0.4 A spikes in CSP.
    Segments now run at the master's rate (step / period) from wherever the
    reference is, correct half of its offset per period, and ride through a
    late target for up to one period. A 0x607A write hook marks every target
    received: an unchanged one is a hold that ends exactly on it, and a
    607A left over from before the mode started no longer moves the motor.
    CSP s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
2026-10-18 Perf: trim the control ISR (loop max 18.9 -> 12.9 us, encoder late 0)
    Measured with DWT checkpoints: HAL_ADC_IRQHandler x2 on the first
    conversion took 3.6 us before currentLoop() started, and the telemetry
    cycle cost 7.2 us (HAL UART DMA start, byte-wise memcpy from flash, DMA
    and UART TC interrupts at priority 0). The ISR ended up to 22 us after
    the current sample, past the next encoder trigger at 20.4 us.
    - cs_adc_irq(): one JEOS interrupt per cycle, register reads; the loop
    starts 2.0-2.5 us after the trigger instead of 4.5 us
    - telemetry: the ISR only fills the values, the link IRQ (priority 1)
    adds the sum and queues it (link_defer())
    - UART: TX DMA by register without interrupts,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
2026-10-18 Fix: detect a lost encoder, stop with ST_ENC_LOST, recover by itself
    A dead or unplugged MT6835 was accepted as a valid angle: MISO stuck low
    reads 00 00 00 00, whose CRC-8 is 0x00, so it passed; stuck high (or a
    stream out of alignment) failed every group, and after 25 failures the
    CRC check switched itself off and the garbage was used. In speed mode the
    PLL then read 0 rpm and the speed PI held rated current at a fixed angle,
    with no trip.
    - MT6835_Sample(): all-0x00 / all-0xFF groups are never an angle; the CRC
    check only switches off if no group has passed since StartBurst()
    - currentLoop() counts cycles without a fresh angle (g_enc_lost_n);
    encoder modes stop after ENC_LOST_N (10 m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
2026-10-18 Fix: bridge re-arm racing a trip, OPAMP start errors, dead break callback
    - checkAndClearBridgeFault() checked g_trip_moe, spent ~50 us on I2C, then
    set MOE. A trip in currentLoop() inside that window (e.g. overvoltage
    with the bridge idle) set g_trip_moe and cleared MOE, and main switched
    it back on. The latch is now checked again with interrupts off, right
    at the enable
    - initCS(): the HAL_OPAMP_Start() results were never assigned, so their
    checks tested the previous ADC status
    - HAL_TIMEx_BreakCallback() removed: TIM_DIER_BIE is never set, so it did
    not run, and if it had, its blocking I2C read at priority 0 (SysTick
    stopped, timeouts never expire) could hang the firmware on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
2026-10-18 Fix: object reads/writes in one access; no stored-param writes while busy
    - read_obj()/od_write() copied values with memcpy(), which newlib-nano
    does byte by byte: a float or counter shared with the control ISR or the
    CANopen tick could be read or written torn. load_obj()/store_obj() use
    one aligned load/store of the object's width
    - od_write() refuses OF_STORED / OF_NOTRUN objects while a calibration
    runs (g_busy): USB already answered ST_BUSY, this covers SDO
2026-10-18 Fix: CANopen FSA, store/restore and driver corner cases
    co402:
    - halt (bit 8) in CSP: the reference brakes from the master's rate to
    rest at 6084 (605D = 2: 6085) through the PP profile and holds
    - a mode change drive_enter() refuses is tried once per 6060 value; the
    old mode carries on and the reason shows (0x4042:2, warning bit)
    - leaving a stop ramp or quick-stop hold switches the loop before any
    reference streams; transition 16 needs a new controlword (after a quick
    stop for a lost master its last one is still enable operation)
    - a trip outside operation is a fault (only a fault reset clears it)
    - following error / 6062 use the ISR's interpolated reference
    (g_pos_ref_cnt), not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
2026-10-18 Fix: plotter event order, queue clearing, log and streamer details
    - protocol.Link: results and events go through one ordered queue; an event
    tagged with the request in flight waits until that request's result is
    queued (a CAL that fails its checks sends ACK and EV_DONE back to back,
    and the GUI saw EV_DONE first). on_event() is called from drain()
    - clear_queue(): dropped requests still get their callback (ST_ABORTED),
    so reply counters are not left waiting; no deque iteration while the
    Link thread pops it; a failed write clears wait_tok (status poll resumed)
    - co_link: Ring.tail(); the Streamer guards read only the newest sample
    instead of copying the whole ring every 5 ms unde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
2026-10-18 Fix: headless USB link survives a drive reset (cotest over USB CDC)
    Over USB CDC the port disappears on every NMT reset node or REBOOT and
    comes back 1-2 s later, while CAN reports the boot-up after ~0.1 s. The
    ST-Link VCP (UART) never dropped, so UsbSerial assumed the port stayed:
    after the identity test every later test failed on a USB timeout.
    - the reader reopens the port when it fails (DTR set again)
    - a write into the old port waits up to 5 s for the reopen, then retries
    Full cotest over USB CDC, twice: 16/17 (store_restore: encoder late
    during the flash write, as before).
2026-10-18 Refc: back to the USB CDC link (reverts the serial debugging switch)
    711e9d3 forced PROTO_LINK_USB 0 for debugging over USART1. The protocol
    goes over the board's USB port again; USART1 stays the build-time
    fallback (PROTO_LINK_USB 0).
    First hardware runs of the USB transport: full cotest twice (16/17, as
    over UART), the plotter config protocol, and a 60 s sensorless sequence
    with 149k telemetry frames and no drops.
2026-10-18 Docs: encoder-loss stop, sensorless and USB transport run on hardware
2026-10-18 Add: KiCad sources of the board (schematic and PCB) under hardware/
2026-10-18 Docs: user manuals for the driver and the PC software, README
    - docs/user-manual-driver.md: connections and pin-outs (from the KiCad
    netlist), first-time setup, commissioning, run modes, angle sources,
    protections, CANopen operation, parameter reference, troubleshooting
    - docs/user-manual-software.md: plotter (Scope, Config, CANopen tabs),
    cotest.py, helper scripts, troubleshooting
    - README.md: project overview, documentation index, repo layout, quick start
2026-10-18 Cleanup: schematic PDF and datasheets moved into hardware/
    Driver TCC.pdf -> hardware/Driver TCC schematic.pdf, the STM32G431 and
    STSPIN32G4 datasheets -> hardware/datasheets/; README and the driver
    manual point at the new paths.
2026-10-18 Docs: handoffs condensed into docs/design-notes.md
    The six per-feature handoffs (config protocol, CANopen drive, CANopen PC
    tool, HFI, sensorless tuning, flash budget) become one design-notes file:
    decisions, bench measurements, procedures and open items, without the
    planning history or the tables the user manuals already have.
    CLAUDE.md, README, the driver manual and the code comments that cited
    the handoffs point at it (comment text only).
2026-10-18 Add: datasheets for the MT6835, DI100N10PQ, TJA1051, USBLC6-2 and the board NTC
    README lists every datasheet in hardware/datasheets/ and links RM0440
    (not included, 39 MB).
2026-10-18 Docs: CLAUDE.md trimmed, points at the manuals and design notes
    Drops history and what the user manuals now cover, fixes the ISR entry
    (cs_adc_irq), the -O2 file list (hfi.c) and the speed-mode prerequisites,
    and notes the peripherals reserved for future use (TIM4 ABI, Hall EXTIs,
    DO1-3, LED, temperature inputs) with the floating Hall-line caveat.
2026-10-18 Docs: software structure flowcharts, developer guide moved to docs/
    CLAUDE.md becomes docs/developer-guide.md; .claude/CLAUDE.md imports it so
    Claude Code still loads it every session. docs/software-structure.md adds
    Mermaid flowcharts of the firmware and PC software. Links updated.
2026-10-18 Plotter: reopen the USB port after a drive reset
    A Reboot or a CANopen reset node drops the CDC port; the plotter now
    retries the same port for 10 s (button reads Cancel meanwhile).
    UsbSync takes a callable for the link, so a cotest request in flight
    is resent on the reopened link.
2026-10-18 Encoder late count ignores the flash-save stall; following-error test tightens the window after enable
2026-10-18 STM32Make.make: source order from the extension's regenerate
2026-10-18 Plotter: USB and CANopen as top-level pages, uniform sidebar width
    Scope and Config move under a USB page with the USB sidebar; CANopen
    becomes its own page beside it. Both sidebars start at the same width
    and carry a dragged width across a page switch.
2026-10-18 STOPPED event reports the gate-driver fault reason and bus voltage
    bridge_fault_info() collects the driver status fault bits (also those the
    auto re-arm already cleared), nFAULT and the TIM1 break flags; the plotter
    names them (VCC UVLO, thermal, VDS, reset).
2026-10-20 CANopen position in Q16.16 turns (0x608F = 2^16 inc/rev)
    g_pos_cnt, g_pos_ref_cnt and g_home_pos are now Q16.16 turns (POS_CNT_SHIFT
    from the 21-bit encoder counts); the CAN side wraps at +-32768 turns. Velocity
    and acceleration objects follow (inc/s, inc/s^2). XDD defaults divided by 32 so
    they keep their physical values; OD.c/OD.h/EDS re-exported. Docs and the
    co_link.py fallback updated.
2026-10-20 Hall angle sources: ang_src 3 (Hall) and 4 (Hall + HFI)
    hall.c polls PC0-2 every cycle (two-sample filter, EXTI0-2 off, pull-ups on),
    interpolates between edges with the speed over the last six edges, clamps to
    the sector, and counts invalid states (ST_HALL_LOST after 10 ms, bridge off,
    EMCY 0x7306). Mode 4 runs HFI seeded by the Hall angle (no polarity pulses),
    re-seeds it when it leaves the Hall sector, and crossfades to the Halls between
    hyb_lo and hyb_hi; the observer blends in above olo in both modes. Position in
    modes 3/4 is the base angle accumulated (Q32.32), so CANopen Q16.16 holds.
    CAL_HALL learns the table from a forced-angle sweep both ways; CAL_UVW sets the
    MT6835 UVW outputs t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
2026-10-20 Hall objects: 0x4011:1-10, 0x4002:12-13; CAL_HALL/CAL_UVW in the Config tab
    0x4011:1 now 0..4; :2-7 the Hall table (Q16 electrical), :8 the live state,
    :9/:10 the Hall + HFI handover speeds. 0x4002:12 Hall bad states, :13 HFI
    re-seeds. Writing the table or the flags rebuilds it. XDD updated; OD.c, OD.h
    and driverTCC.eds still need the export from CANopenEditor.
    GUI: Hall and UVW calibration steps, Hall line in the encoder status, plot
    labels for the Hall sources.
2026-10-20 Docs: Hall angle sources, CAL_HALL / CAL_UVW, CCM budget
2026-10-20 CAL_UVW moves the encoder zero onto electrical zero
    After 'e', at the motor's pole pairs, CAL_UVW also writes ZERO_POS so the
    encoder (and so the UVW outputs) reads 0 at electrical zero: the UVW edges sit
    like well-mounted Hall sensors. elec_offset keeps the 0.088 deg rounding, so 'e'
    need not be rerun; the Hall table is cleared. EV_UVW reports the shift and the
    offset before and after.
2026-10-21 Hall speed per edge from the calibrated sector width
    The six-edge average lagged a whole electrical turn when the speed changed,
    which put the mode 3 speed loop into a limit cycle at 100 rpm on the bench.
    The table already carries each sensor's placement error, so the speed is now
    the width of the sector just crossed over its time: one sector behind. The
    late-edge decay uses the present sector's width. Bench results in the design
    notes.
2026-10-22 Docs: Hall bench results, choosing angle source 3 or 4
    Design notes: speed, position, torque and hand-load results against the
    encoder, the unexplained runaway after soldering live and the CRC switch-off
    suspect, open items. Driver manual: when to use 3 or 4, low-speed gains in 3,
    the HFI breakaway effect and the coarse position with the motor off in 4,
    bench-test precautions (save after u, solder unpowered), troubleshooting row.
    Developer guide: measured loop time maxima.
2026-10-22 Docs: the observer weight at 600 rpm is what olo/ohi give
2026-10-22 Volts to duty over the real duty window; kv fits the voltage magnitude
    SVPWM() spans 0..ARR - ZERO_TIME, but the volts were converted as if the
    duty swung the full period: applied volts were 3299/3399 of the command,
    so kv read ~3 % low and R ~3 % high. currentLoop() now scales the bus by
    duty_k = g_max_duty_cycle / g_pwm_res. Bench A/B on a cold motor: R with
    the old scaling 0.971 x higher, as predicted.
    The kv coast-down fits |v - R*i| instead of vq, so a frame angle error
    cannot bias it, and EV_KV adds vd/vq (shown as the frame angle error).
    Bench: kv 344.8 -> 348.4 rpm/V, angle error +-0.2 deg.
2026-10-22 VDDA measured against VREFINT at boot
    The current and bus voltage scaling assumed VDDA = 3.3 V; the board has
    3.315 V and the bus read 1 % low (30.71 V against 31.02 V on a meter).
    initCS() now averages 16 VREFINT conversions after the ADC calibration
    and scales from the factory value (3.3 V fallback). Bus now reads 31.02 V.
2026-10-22 Headless command line for USB and CANopen commands
    software/drivectl.py: the Config tab's USB commands (get/set, save, cal,
    run modes, export/import, telemetry to CSV, watch) and CANopen master
    commands (SDO, NMT, CiA 402 walk, PV, PP, homing, store, EMCY), without
    Qt. One-shot, ';'-separated, script (-f) or interactive shell; exit code
    for scripts; Ctrl-C stops the motor. --usb auto picks the port that
    answers PING (SLCAN adapters share the ST VID:PID).
    co_link.UsbSerial passes telemetry frames to on_telem; protocol.py gets
    TELEM_NAMES for the CSV columns. Docs: software manual section 8,
    developer guide, structure diagrams.
2026-10-22 Temperature measurement and over-temperature protection
    Board NTC (TH1, PC4), MCU die sensor and an optional motor NTC on J12
    (PC3) are read with the ADCs' regular channels. Main arms a conversion,
    the TIM1 bottom interrupt starts it, so it ends (1.4 us, die 6.1 us)
    long before the CC4 current sample. The TIM1 update interrupt now stays
    on without the encoder burst.
    The current cap falls from imax to zero over the 10 C below a limit
    (tmax board, mtmax motor, 110 C die): the speed loop limit (g_i_vel),
    the CST reference and a current-mode iq_ref; not in currentLoop(), CCM
    is full. At the limit the run stops (ST_OVERTEMP / ST_MOTOR_OVERTEMP,
    EMCY 0x4210 / 0x4310) and starts again 10 C below.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
2026-10-22 Observer blend thresholds in rpm, like the Hall + HFI handover
    olo/ohi (0x4030:3/4) were volts of peak back-EMF, computed from the base
    speed and kv, next to hyblo/hybhi in rpm. Both are rpm now (defaults
    425/850, 0.7/1.4 V on the bench motor); obs_weight() compares the base
    speed directly, which frees 48 bytes of CCM. PARAM_VERSION 9.
    JSON imports (Config tab, drivectl) skip values whose recorded unit has
    changed since the export.
2026-10-22 Fix: encoder CRC check no longer switches off after a recovery
    MT6835_StartBurst() cleared crc_seen, so a burst restarted by
    enc_recover() after a supply dip could turn the CRC check off after 25
    failed groups and take corrupted groups as angles (the suspect in the
    runaway after soldering the UVW wires live). crc_seen now lasts from
    boot: once a group has passed, the check stays on.
    Checked on the bench by toggling SPI1 CPHA through the debugger with
    the motor off: the old firmware switched the check off and used the bad
    groups; with the fix the check stays on and reads resume cleanly.
2026-10-22 Position-request latch and trip coast to flash: 656 B of CCM back
    motion_latch() (home, position reference / CSP segment, position here) and
    trip_coast() (trip latch, MOE off outside CTRL_RUN, coast checks, OV resume)
    run only on the cycles that need them, so they move out of currentLoop() into
    flash. CCMRAM 10 144 -> 9 488 B (debug), 10 168 -> 9 464 B (release).
2026-10-22 Docs: drop the outer_loops-to-flash option
    The CCM room now comes from the request and trip paths; hall_update() back in
    CCM is the margin option for Hall + HFI.
2026-10-22 Docs: plan for AS5048A support next to the MT6835
    Design notes section 9 records how a second encoder type would be added
    (enc_type parameter, enc layer, one-frame AS5048A read, calibrations, CCM
    budget, work order); not implemented.
2026-10-22 Fix: USB requests timing out in the plotter (pyserial GetLastError race)
    pyserial 3.5 on Windows reads GetLastError() as a separate ctypes call after
    ReadFile/WriteFile; a GIL hand-over in between leaves ERROR_TIMEOUT (1460) or 0
    there, so a healthy port raised "ReadFile failed". The plotter then dropped the
    port every 20-40 s, and a failed write ended its sender thread silently: every
    request timed out while telemetry still flowed. serial_fix.py rebinds the
    kernel32 calls with use_last_error=True (imported by plotter.py and co_link.py).
    The plotter's sender now reports a write error so the port is reopened.
    Bench, plotter on screen: 150 s connected with no disconnect and 0 timeouts
    (before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
2026-10-22 USB: own VID:PID 1209:0001 so the driver isn't confused with the SLCAN adapter
    CubeMX's CDC default 0483:5740 is shared by CANable-style SLCAN adapters,
    so the plotter and drivectl --usb auto could pick the CAN adapter. The
    driver now enumerates as 1209:0001 (pid.codes test PID) with the product
    string "Driver TCC motor driver", set in USER CODE PRIVATE_DEFINES of
    usbd_desc.c so a CubeMX regenerate keeps it. PC tools and manuals updated.
2026-10-22 Rename the project to fluxdrive-g4
    The repo is now alanhpereira/fluxdrive-g4. Renamed to match: the CubeMX
    project (fluxdrive-g4.ioc, build target and .elf/.map), the CANopen XDD
    and EDS (product name and 0x1008 device name; OD.c/OD.h edited to match,
    0x1008 grows to 13 bytes), the KiCad project and schematic PDF, the USB
    manufacturer/product strings, the plotter title and the docs.
    The plotter's QSettings key and the JSON backup tag driverTCC-params stay,
    so saved GUI settings and old backups still load.
    The 0x1008 size changes the OD layout signature: each board ignores its
    stored CANopen record once and loads the defaults (node ID and bit rate
    are kept); set the CAN settings again and S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
2026-10-23 Hardware license CERN-OHL-P-2.0; link the datasheets instead of shipping them
    hardware/ is now under the CERN Open Hardware Licence v2 - Permissive
    (hardware/LICENSE); the firmware and PC software stay MIT. The README
    lists both and the licenses of the third-party code (CMSIS, the HAL,
    CANopenNode, ST's USB device library under SLA0044).
    The part datasheets are the manufacturers' documents: they are no longer
    tracked. hardware/README.md describes the KiCad project and links each
    datasheet; hardware/datasheets/ is git-ignored for local copies.
2026-10-23 Rename plotter.py to fluxstudio.py (Flux Studio)
    It long stopped being only a plotter: telemetry, parameters,
    calibration and a CANopen master. The window title and the docs call it
    Flux Studio. The QSettings key stays ("driverTCC", "plotter"), so saved
    ports and layout still load.
2026-10-23 Keep this machine's toolchain paths out of the repo
    .stm32env (ARM_GCC_PATH, OPENOCD) is now git-ignored: the STM32 for
    VSCode extension creates it per machine, and without it make uses the
    tools on PATH. The cortex-debug tool paths move from the workspace
    settings to the VS Code user settings. The developer guide says where
    each one lives.
2026-10-23 README: ratings (70 V / 15 A design, tested to 32 V / 10 A), status and safety warning
2026-10-23 README: photo of the board
